R-Mutura/USB_HUB_ADAPTER/IMAGES/USB_HUB_ADAPTER 2.png

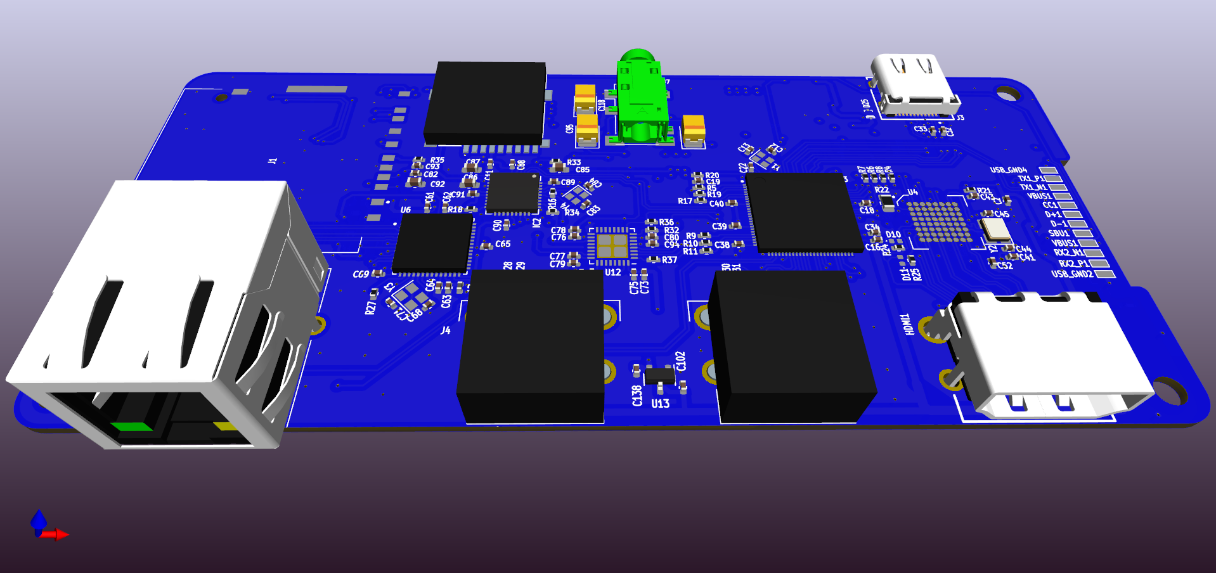
IMAGES/USB_HUB_ADAPTER 2.png
