R-Mutura/USB_HUB_ADAPTER/IMAGES/USB_HUB_ADAPTER 3.png

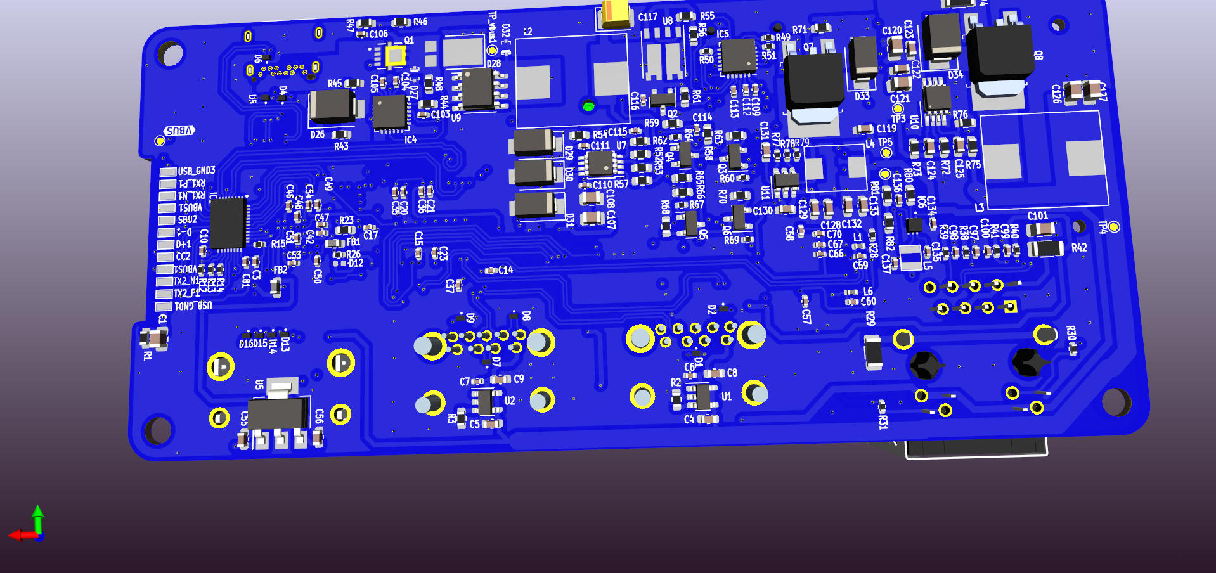
IMAGES/USB_HUB_ADAPTER 3.png
