R-Mutura/USB_HUB_ADAPTER/IMAGES/USB_HUB_ADAPTER.png

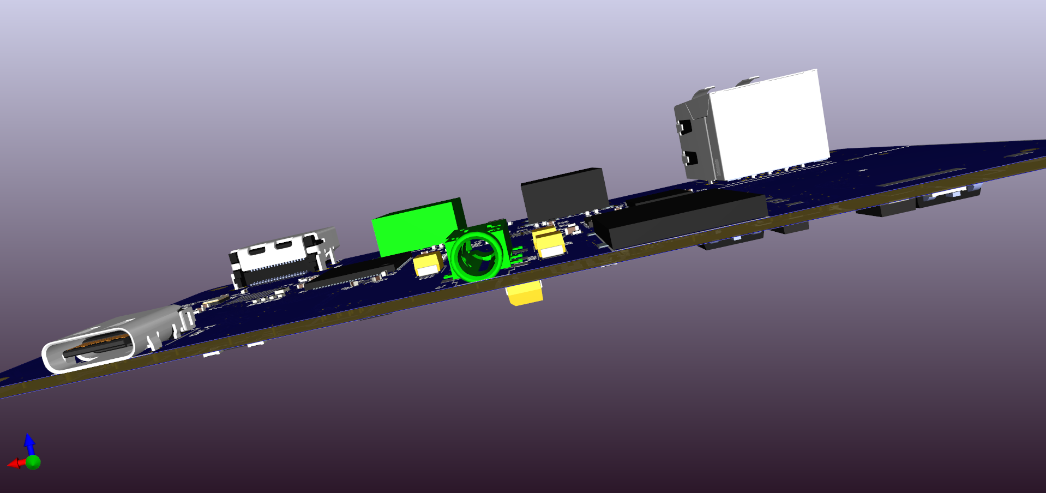
IMAGES/USB_HUB_ADAPTER.png
