R-Mutura/USB_HUB_ADAPTER/BOM/USB_HUB_ADAPTER_V2.xlsx

Reference(s) | Value | Footprint | Description | Mfr No. | Vendor | Qty | Price per unit | Total price
C1 | 100nF | Capacitor_SMD:C_0805_2012Metric |  | 08056D104KAT2A | LCSC | 1 | $0.0084 | $0.0084
C2, C6, C7, C10, C57, C58, C59, C60, C61, C62, C63, C64, C65, C66, C67, C69, C70, C72, C73, C77, C79, C80, C81 | 100nF | Capacitor_SMD:C_0402_1005Metric |  | 0402B104K6R3CT | LCSC | 23 | $0.0012 | $0.0276
C3, C19, C74, C75, C76, C94, C104, C105, C109, C112, C113, C134 | 1uF | Capacitor_SMD:C_0402_1005Metric |  | CL05A105KQ5NNNC | LCSC | 12 | $0.0008 | $0.0096
C4, C5, C8, C9, C55, C56, C128, C129 | 10uF | Capacitor_SMD:C_0603_1608Metric |  | CL10A106MQ8NNNC | LCSC | 8 | $0.0049 | $0.0392
C11, C82, C93 | 1nF | Capacitor_SMD:C_0402_1005Metric |  | C0402C102J1GEC7411 | LCSC | 3 | $0.0182 | $0.0546
C12, C13, C44, C45, C68, C71 | 22pF | Capacitor_SMD:C_0402_1005Metric |  | CC0402JRNPO9BN220 | LCSC | 6 | $0.0010 | $0.0060
C14, C15, C16, C17, C18, C20, C21, C22, C23, C28, C29, C30, C31, C32, C33, C34, C35, C36, C37, C38, C39, C40, C41, C42, C43, C46, C47, C48, C49, C50, C51, C53, C54, C88, C89, C90, C91, C116 | 0.1uF | Capacitor_SMD:C_0402_1005Metric |  | 0402B104K160NT | LCSC | 38 | $0.0008 | $0.0304
C52 | 2.2uF | Capacitor_SMD:C_0402_1005Metric |  | JMK105BJ225MV-F | LCSC | 1 | $0.0024 | $0.0024
C78 | 10uF | Capacitor_SMD:C_0402_1005Metric |  | CL05A106MQ5NUNC | LCSC | 1 | $0.0053 | $0.0053
C83, C84 | 18pF | Capacitor_SMD:C_0402_1005Metric |  | C0402C180K8HAC7867 | LCSC | 2 | $0.0049 | $0.0098
C85, C86 | 1uF_1%_0.1ohm | Capacitor_SMD:C_0603_1608Metric |  | 0603X105K6R3CT | LCSC | 2 | $0.0055 | $0.0110
C87, C92 | 4.7uF | Capacitor_SMD:C_0603_1608Metric |  | CL10A475KQ8NNNC | LCSC | 2 | $0.0037 | $0.0074
C95, C96 | 100uF | Capacitor_Tantalum_SMD:CP_EIA-3528-21_Kemet-B |  | TLJB227M006R0500 | LCSC | 2 | $0.2451 | $0.4902
C97, C98, C99, C100 | 15pF | Capacitor_SMD:C_0402_1005Metric | 50V | 0402CG150J500NT | LCSC | 4 | $0.0010 | $0.0040
C101 | 22pF | Capacitor_SMD:C_0805_2012Metric |  | TCC0805COG220J500BT | LCSC | 1 | $0.0045 | $0.0045
C103 | 1uF_50V | Capacitor_SMD:C_0402_1005Metric |  | CL05A105KA5NQNC | LCSC | 1 | $0.0034 | $0.0034
C106, C110 | 0.1uF_25V | Capacitor_SMD:C_0402_1005Metric |  | GMC04X7R104K25NT | LCSC | 2 | $0.0030 | $0.0060
C111 | 1nF>25v | Capacitor_SMD:C_0402_1005Metric |  | CC0402KRX7R9BB102 | LCSC | 1 | $0.0009 | $0.0009
C114, C115 | 100pF | Capacitor_SMD:C_0402_1005Metric |  | CC0402JRNPO7BN101 | LCSC | 2 | $0.0014 | $0.0028
C117, C118 | 4.7uF | Capacitor_Tantalum_SMD:CP_EIA-3528-21_Kemet-B |  | T494B475K016AT | LCSC | 2 | $0.1872 | $0.3744
C119 | 4.7uF | Capacitor_SMD:C_0603_1608Metric | X5R | CL10A475KQ8NNNC | LCSC | 1 | $0.0037 | $0.0037
C107, C108, C120, C121, C126, C127 | 22uF | Capacitor_SMD:C_0805_2012Metric |  | CL21A226MOQNNNE | JLC | 6 | $0.0236 | $0.1416
C122, C130, C131 | 100nF | Capacitor_SMD:C_0603_1608Metric |  | CL10B104KO8NNNC | LCSC | 3 | $0.0023 | $0.0069
C123 | 470nF | Capacitor_SMD:C_0603_1608Metric |  | CC0603KRX7R7BB474 | LCSC | 1 | $0.0069 | $0.0069
C124 | 1nF | Capacitor_SMD:C_0603_1608Metric |  | CC0603KRX7R6BB102 | LCSC | 1 | $0.0029 | $0.0029
C125 | 1.2nF | Capacitor_SMD:C_0603_1608Metric |  | CC0603JRNPO8BN122 | LCSC | 1 | $0.0087 | $0.0087
C132, C133 | 22uF | Capacitor_SMD:C_0603_1608Metric |  | CL10A226MQ8NRNC | JLC | 2 | $0.0044 | $0.0088
C135 | 4.7uF | Capacitor_SMD:C_0402_1005Metric |  | GRM155R60J475ME87D | LCSC | 1 | $0.0046 | $0.0046
C136 | 120pF_1mOHM | Capacitor_SMD:C_0402_1005Metric |  | 0402B121K500NT |  | 1 | $0.0009 | $0.0009
C137 | 10uF_1mOHM_402 | Capacitor_SMD:C_0402_1005Metric |  | CL05A106MQ5NUNC |  | 1 | $0.0053 | $0.0053
D1, D2, D3, D4, D5, D6, D7, D8, D9, D13, D14, D15, D16 | TVS_SS-ESD122DMXR | greencharge-footprints:DMX0003A | 2-Channel ESD Protection Diode for USB Type-C and HDMI 2.0 | ESD122DMXR | LCSC | 13 | $0.2944 | $3.8272
D10, D11, D12 | D | Diode_SMD:D_0402_1005Metric |  | B5817WS | LCSC | 3 | $0.0168 | $0.0504
D25, D27, D32 | ESDA25P35 | digikey-footprints:SOD-523 | TVS DIODE 3.3V 14.1V SOD523 | ESDA25P35-1U1M | LCSC | 3 | $0.3209 | $0.9627
D26 | SSB44-E3/52T | Diode_SMD:D_SMB |  | ESD5Z3.3T1G-MS | LCSC | 1 | $0.0140 | $0.0140
D28 | SBR10U45SP5-13 | Diode_SMD:D_PowerDI-5 |  | SBR10U45SP5-13 | LCSC | 1 | $0.4089 | $0.4089
D29, D30, D31, D33 | SMAJ30A | Diode_SMD:D_SMA |  | SMAJ30A | LCSC | 4 | $0.0261 | $0.1044
D34 | SK106B | Diode_SMD:D_SMB |  | SK106B | LCSC | 1 | $0.1488 | $0.1488
FB1, FB2 | Ferrite Bead | Inductor_SMD:L_0603_1608Metric |  | YI160808U300-5R0T | LCSC | 2 | $0.0138 | $0.0276
HDMI1 | HDMI_CONN_19pin | greencharge-footprints:HDMI_FEMALE_CONN_685119134923 |  | HDMI-101L | LCSC | 1 | $0.4757 | $0.4757
IC1 | TUSB564 | greencharge-footprints:TUSB564 | USB TYPE-C DP Alt Mode Linear Redriver Crosspoint Switch for Sink Side | HD3SS460RHRR | LCSC | 1 | $2.3562 | $2.3562
IC2 | USB2240-AEZG-06 | Package_DFN_QFN:QFN-36-1EP_6x6mm_P0.5mm_EP3.7x3.7mm | USB2240-AEZG-06, USB Controller 35Mbit/s USB 2.0, 3.3 V, 36-Pin, QFN | USB2240-AEZG-06 | LCSC | 1 | $1.2600 | $1.2600
IC4 | STUSB4500QTR-Interface_USB | Package_DFN_QFN:QFN-24-1EP_4x4mm_P0.5mm_EP2.7x2.7mm |  | STUSB4500QTR | DIGIPART/GANG BO INDUSTRIAL | 1 | $2.2500 | $2.2500
IC5 | STUSB4700YQTR | Package_DFN_QFN:QFN-24-1EP_4x4mm_P0.5mm_EP2.7x2.7mm | USB Interface IC CONDITIONING & INTERFACES | STUSB4700YQTR | LCSC | 1 | $2.3960 | $2.3960
IC6 | TPS62824ADMQR | greencharge-footprints:TPS62824ADMQR | Switching Voltage Regulators 2.4-V to 5.5-V input, 1-A step-down converter with forced PWM in 1.5-mm 1.5-mm QFN package 6-VSON-HR -40 to 125 | TPS62821DLCT | LCSC | 1 | $3.6735 | $3.6735
J1 | SD-106M | greencharge-footprints:sd_card_SD106M | Connector - Card Sockets 29.2x28.5x2.8mm | SD-106M | LCSC | 1 | $0.4010 | $0.4010
J2 | TF-115-BCP9 | greencharge-footprints:sd_tf_card_TF115BCP9 | -25~{+85} 1.8mm Tin Deck MicroSD card (TF card) 260 C5191 Self bomb SMD SD Card Connectors ROHS | TF-115-BCP9 | LCSC | 1 | $0.0805 | $0.0805
J3 | TYPEC-324DBW-ACP24A | greencharge-footprints:GCT_USB4056-03-A_REVA |  | TYPEC-324DBW-ACP24A | LCSC | 1 | $0.4948 | $0.4948
J4, J5 | USB3_A | greencharge-footprints:usb_A_3.0_U231091N3GRC105 |  | U231-091N-3GRC10-5 | LCSC | 2 | $0.3325 | $0.6650
J6 | RJ_45_CONN_100G_J1B1211CCD | greencharge-footprints:RJ45_CONN_J1B1211CCD |  | J1B1211CCD | LCSC | 1 | $2.4055 | $2.4055
J7 | 54-00178 | Connector_Audio:Jack_3.5mm_PJ311_Horizontal |  | PJ-3111-3A | LCSC | 1 | $0.1735 | $0.1735
L1, L6 | 0.5A_120R_100MHz | Inductor_SMD:L_0402_1005Metric |  | HK10053N6S-T | LCSC | 2 | $0.0051 | $0.0102
L2 | MWSA1004S-100MT | greencharge-footprints:MWSA1004S-3R3MT | 7.8A 10uH Â±20% 30mÎ© SMD Power Inductors ROHS | MWSA1004S-100MT | LCSC | 1 | $0.1991 | $0.1991
L3 | 8.2uH_8A | greencharge-footprints:MWSA1004S-3R3MT |  | MWSA1004S-8R2MT | LCSC | 1 | $0.2162 | $0.2162
L4 | YSPI0520-4R7M | greencharge-footprints:YSPI0520 |  | YSPI0520-4R7M | LCSC | 1 | $0.1721 | $0.1721
L5 | 470nH_30m | greencharge-footprints:DFE252012PD-xxx |  | DFE252012PD-R47M=P2 | LCSC | 1 | $0.1826 | $0.1826
L7 | 2A_BEAD | Inductor_SMD:L_0402_1005Metric |  | HCB1005KF-100T20 | LCSC | 1 | $0.0032 | $0.0032
Q1 | STL6P3LLH6 | greencharge-footprints:STL6P3LLH6 |  | STL6P3LLH6 | DIGIPART/WINSOURCE | 1 | $0.4870 | $0.4870
Q2 | SI2307A | Package_TO_SOT_SMD:SOT-23 |  | SI2307A | LCSC | 1 | $0.0447 | $0.0447
Q3, Q4, Q5, Q6 | BSH105,215 | Package_TO_SOT_SMD:SOT-23 | MOSFET N-CH 60V 0.36A SOT-23 | 2N7002-HXY | LCSC | 4 | $0.0152 | $0.0608
Q7 | HSU4103 | greencharge-footprints:TO-252-3_tabpin-2 |  | HSU4103 | LCSC | 1 | $0.2349 | $0.2349
Q8 | AP25P06K | greencharge-footprints:TO-252-3_tabpin-2 |  | AP25P06K | LCSC | 1 | $0.1265 | $0.1265
R1 | 0R | Resistor_SMD:R_0603_1608Metric |  | FRC0603P000 TS | LCSC | 1 | $0.0007 | $0.0007
R2, R3 | 6.8K | Resistor_SMD:R_0603_1608Metric |  | FRC0603J682 TS | LCSC | 2 | $0.0008 | $0.0016
R4, R12, R13, R14, R15 | 1K | Resistor_SMD:R_0402_1005Metric |  | FRC0402J102 TS | LCSC | 5 | $0.0004 | $0.0020
R5, R6, R7, R8, R9, R19, R32, R34, R35, R36, R79 | 10K | Resistor_SMD:R_0402_1005Metric |  | 0402WGJ0103TCE | LCSC | 11 | $0.0004 | $0.0044
R10, R11 | 200K | Resistor_SMD:R_0402_1005Metric |  | 0402WGJ0204TCE | LCSC | 2 | $0.0004 | $0.0008
R16 | 1M | Resistor_SMD:R_0402_1005Metric |  | FRC0402J105 TS | LCSC | 1 | $0.0004 | $0.0004
R17 | 47K | Resistor_SMD:R_0402_1005Metric |  | 0402WGJ0473TCE | LCSC | 1 | $0.0004 | $0.0004
R18, R49, R50, R51, R60, R64, R67, R69 | 100K | Resistor_SMD:R_0402_1005Metric |  | 0402WGJ0104TCE | LCSC | 8 | $0.0004 | $0.0032
R20, R27, R28 | 12K | Resistor_SMD:R_0402_1005Metric |  | CR0402JF0123G | LCSC | 3 | $0.0004 | $0.0012
R21 | 2.2K_402 | Resistor_SMD:R_0402_1005Metric |  | 0402WGJ0222TCE | LCSC | 1 | $0.0004 | $0.0004
R22 | 100K | Resistor_SMD:R_0805_2012Metric |  | FRC0805J104 TS | LCSC | 1 | $0.0012 | $0.0012
R23 | 249OHM/1% | Resistor_SMD:R_0603_1608Metric |  | 0603WAF2490T5E | LCSC | 1 | $0.0010 | $0.0010
R24, R25, R26 | 4.7K | Resistor_SMD:R_0402_1005Metric |  | 0402WGJ0472TCE | LCSC | 3 | $0.0004 | $0.0012
R29, R42 | 0R_1206 | Resistor_SMD:R_1206_3216Metric |  | FRC1206P000 TS | LCSC | 2 | $0.0020 | $0.0040
R30, R31 | 332R | Resistor_SMD:R_0402_1005Metric |  | 0402WGF3320TCE | LCSC | 2 | $0.0005 | $0.0010
R33 | 12K_1% | Resistor_SMD:R_0402_1005Metric |  | 0402WGF1202TCE | LCSC | 1 | $0.0005 | $0.0005
R37, R38, R39, R40, R41 | 49.9R | Resistor_SMD:R_0402_1005Metric |  | 0402WGF499JTCE | LCSC | 5 | $0.0005 | $0.0025
R43 | 470 | Resistor_SMD:R_0603_1608Metric |  | FRC0603J471 TS | LCSC | 1 | $0.0007 | $0.0007
R44, R48 | 1K | Resistor_SMD:R_0603_1608Metric |  | 0603WAF1001T5E | LCSC | 2 | $0.0005 | $0.0010
R45, R52, R80, R82 | 100K | Resistor_SMD:R_0603_1608Metric |  | FRC0603F2003TS | LCSC | 4 | $0.0009 | $0.0036
R46, R47 | 22K | Resistor_SMD:R_0603_1608Metric |  | FRC0603J223 TS | LCSC | 2 | $0.0008 | $0.0016
R53 | 11K | Resistor_SMD:R_0603_1608Metric |  | 0603WAJ0113T5E | LCSC | 1 | $0.0009 | $0.0009
R54 | 47.5K | Resistor_SMD:R_0603_1608Metric |  | FRC0603F4752TS | LCSC | 1 | $0.0009 | $0.0009
R55, R61, R71, R75 | 10K | Resistor_SMD:R_0603_1608Metric |  | FRC0603J103TS | LCSC | 4 | $0.0007 | $0.0028
R56 | 2.2K | Resistor_SMD:R_0603_1608Metric |  | FRC0603J222 TS | LCSC | 1 | $0.0008 | $0.0008
R57 | 270 | Resistor_SMD:R_0603_1608Metric |  | FRC0603J271 TS | LCSC | 1 | $0.0008 | $0.0008
R58 | 9.53K | Resistor_SMD:R_0603_1608Metric |  | 0603WAF9531T5E | LCSC | 1 | $0.0011 | $0.0011
R59 | 820 | Resistor_SMD:R_0603_1608Metric |  | 0603WAJ0821T5E | LCSC | 1 | $0.0008 | $0.0008
R62 | 30K | Resistor_SMD:R_0603_1608Metric |  | FRC0603J303 TS | LCSC | 1 | $0.0008 | $0.0008
R63 | 8.87K_603 | Resistor_SMD:R_0603_1608Metric |  | 0603WAF8871T5E | LCSC | 1 | $0.0009 | $0.0009
R65 | 3K_603 | Resistor_SMD:R_0603_1608Metric |  | FRC0603J302 TS | LCSC | 1 | $0.0008 | $0.0008
R66 | 2.4K_603 | Resistor_SMD:R_0603_1608Metric |  | 0603WAJ0242T5E | LCSC | 1 | $0.0008 | $0.0008
R68 | 3.65K_603 | Resistor_SMD:R_0603_1608Metric |  | 0603WAF3651T5E | LCSC | 1 | $0.0009 | $0.0009
R70 | 2.2K_805 | Resistor_SMD:R_0603_1608Metric |  | FRC0603J222 TS | LCSC | 1 | $0.0008 | $0.0008
R72 | 44.2K | Resistor_SMD:R_0603_1608Metric |  | FRC0603F4422TS | LCSC | 1 | $0.0009 | $0.0009
R73 | 2.21K | Resistor_SMD:R_0603_1608Metric |  | FRC0603F2211TS | LCSC | 1 | $0.0009 | $0.0009
R74 | 10m | Resistor_SMD:R_1206_3216Metric |  | MFJ06HR010FT | LCSC | 1 | $0.0405 | $0.0405
R76 | 3.32K | Resistor_SMD:R_0603_1608Metric |  | 0603WAF3321T5E | LCSC | 1 | $0.0009 | $0.0009
R77 | 30R | Resistor_SMD:R_0402_1005Metric |  | 0402WGJ0300TCE | LCSC | 1 | $0.0004 | $0.0004
R78 | 30.9K | Resistor_SMD:R_0402_1005Metric |  | FRC0402F3092TS | LCSC | 1 | $0.0005 | $0.0005
R81 | 82.5K | Resistor_SMD:R_0603_1608Metric |  | 0603WAF8252T5E | LCSC | 1 | $0.0009 | $0.0009
U1, U2 | SY6280 | Package_TO_SOT_SMD:SOT-23-5 |  | SY6280AAC | JLC | 2 | $0.1847 | $0.3694
U3 | USB7206-usb_hub_controller | greencharge-footprints:QFN-100_40P1200X1200X90-101N-D |  | USB7206CT/KDX | MOUSER | 1 | $11.0300 | $11.0300
U4 | MCDP2900 | greencharge-footprints:BGA-64_8x8_7.0x7.0mm_MCDP2900 |  | MCDP2900A4T | DIGIKEY | 1 | $11.1500 | $11.1500
U5 | ZLDO1117G12TA | Package_TO_SOT_SMD:SOT-223-3_TabPin2 |  | ZLDO1117G12TA | JLC | 1 | $0.3362 | $0.3362
U6 | LAN9500AI-ABZJ-TR | greencharge-footprints:LAN950X_QFN50P800X800X100-57N |  | LAN9500AI-ABZJ-TR | JLC | 1 | $3.6795 | $3.6795
U7 | LM3489QMM | Package_SO:TSSOP-8_3x3mm_P0.65mm |  | LM3489MM/NOPB | JLC | 1 | $1.9600 | $1.9600
U8 | SQJ951EP | Package_SO:PowerPAK_SO-8_Dual |  | SQJ951EP-T1_GE3 | MOUSER | 1 | $1.7500 | $1.7500
U9 | CWDM3011P | Package_SO:SOIC-8_3.9x4.9mm_P1.27mm |  | CWDM3011P TR13 PBFREE | DIGIKEY | 1 | $0.9700 | $0.9700
U10 | LM25085MM/NOPB | Package_SO:VSSOP-8_3.0x3.0mm_P0.65mm |  | LM25085MM/NOPB | JLC | 1 | $1.6710 | $1.6710
U11 | TPS56339DDCR | Package_TO_SOT_SMD:SOT-23-6 |  | TPS56339DDCR | JLC | 1 | $2.5365 | $2.5365
U12 | TLV320AIC3104IRHBR | Package_DFN_QFN:VQFN-32-1EP_5x5mm_P0.5mm_EP3.5x3.5mm |  | TLV320AIC3104IRHBR | JLC | 1 | $1.7550 | $1.7550
Y1 | 25MHz_402F2501XIAR | Crystal:Crystal_SMD_2016-4Pin_2.0x1.6mm |  | ABM11-25.000MHZ-D2X-T3 | DIGIKEY | 1 | $0.7300 | $0.7300
Y2 | 27MHz | Crystal:Crystal_SMD_Abracon_ABM8G-4Pin_3.2x2.5mm |  | ABM8G-27.000MHZ-B4Y-T | DIGIKEY | 1 | $0.6400 | $0.6400
Y3 | 25MHz | Crystal:Crystal_SMD_2520-4Pin_2.5x2.0mm |  | 7E25000E12UCG | LCSC | 1 | $0.1306 | $0.1306
Y4 | 24.0MHz | Crystal:Crystal_SMD_2016-4Pin_2.0x1.6mm |  | ABM11-24.000MHZ-D2X-T3 | DIGIKEY | 1 | $0.7400 | $0.7400
 |  |  |  |  |  |  | TOTAL | $64.7409
