R-Mutura/USB_HUB_ADAPTER/USB_HUB_ADAPTER/AUDIO_DAC_CONVERTER.kicad_sch

## KiCad design USB_HUB_ADAPTER/AUDIO_DAC_CONVERTER.kicad_sch (2022-11-23)

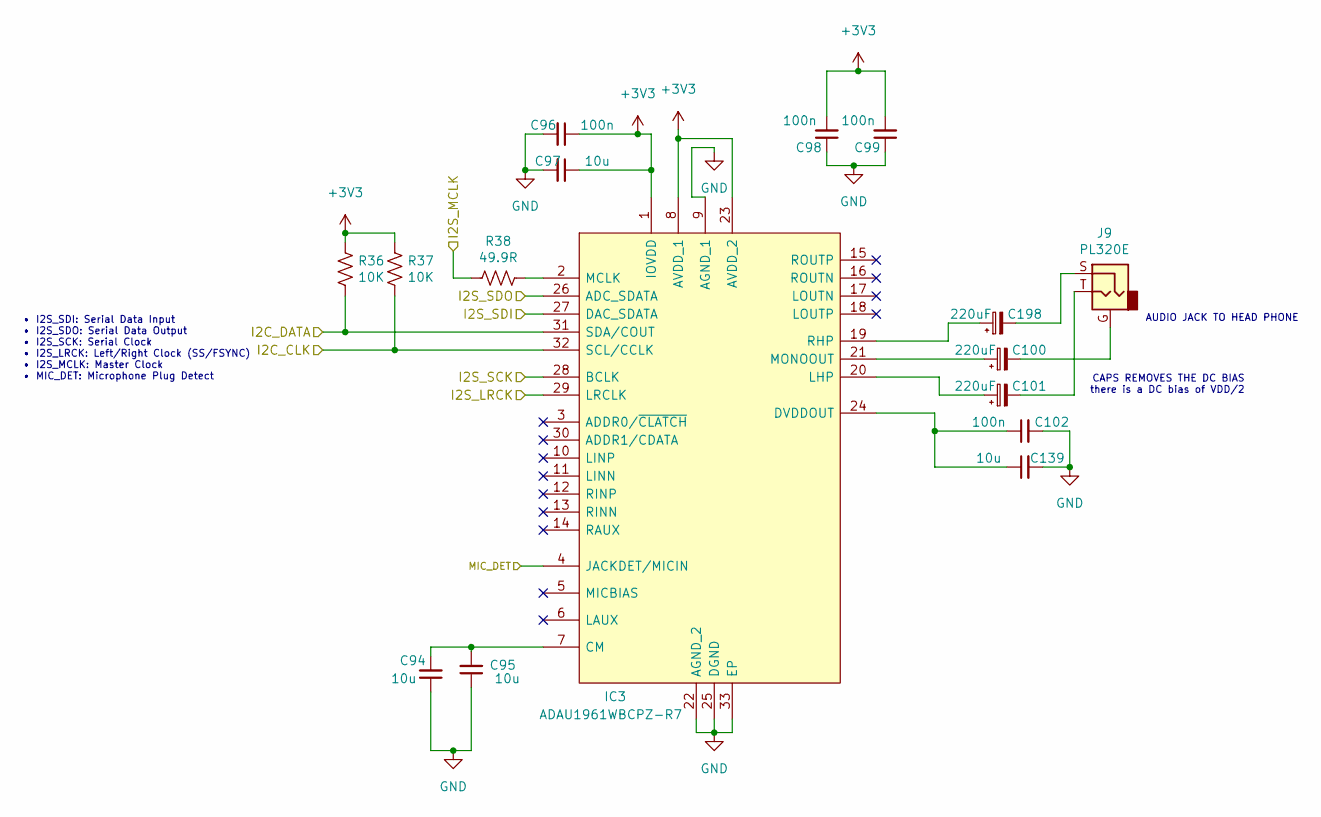
[picture p17: schematic AUDIO_DAC_CONVERTER.kicad_sch]

Parts:
C94, C95: 10u; C_0603_1608Metric
C96, C98, C99, C102: 100n; C_0402_1005Metric
C97, C139: 10u; C_0402_1005Metric
C100, C101, C198: 220uF; CP_EIA-3528-21_Kemet-B
IC3: ADAU1961WBCPZ-R7; LFCSP-32-1EP_5x5mm_P0.5mm_EP3.6x3.6mm; Mouser Part Number 584-ADAU1961WBCPZ-R7
J9: PL320E; Jack_3.5mm_PJ320E_Horizontal
R36, R37: 10K; R_0402_1005Metric
R38: 49.9R; R_0402_1005Metric

Connections:
+3V3: C96.1, C97.1, C98.2, C99.2, IC3.1 (IOVDD), IC3.8 (AVDD_1), IC3.23 (AVDD_2), R36.1, R37.1
GND: C94.1, C95.1, C96.2, C97.2, C98.1, C99.1, C102.2, C139.2, IC3.9 (AGND_1), IC3.22 (AGND_2), IC3.25 (DGND), IC3.33 (EP)
I2C_CLK: IC3.32 (SCL/CCLK), R37.2
I2C_DATA: IC3.31 (SDA/COUT), R36.2
I2S_LRCK: IC3.29 (LRCLK)
I2S_MCLK: R38.1
I2S_SCK: IC3.28 (BCLK)
I2S_SDI: IC3.27 (DAC_SDATA)
I2S_SDO: IC3.26 (ADC_SDATA)
MIC_DET: IC3.4 (JACKDET/MICIN)
unnamed: C94.2, C95.2, IC3.7 (CM)
unnamed: C100.1, IC3.21 (MONOOUT)
unnamed: C100.2, J9.G
unnamed: C101.1, IC3.20 (LHP)
unnamed: C101.2, J9.T
unnamed: C102.1, C139.1, IC3.24 (DVDDOUT)
unnamed: C198.1, IC3.19 (RHP)
unnamed: C198.2, J9.S
unnamed: IC3.2 (MCLK), R38.2

Notes on the sheet:
AUDIO JACK TO HEAD PHONE
• I2S_SDI: Serial Data Input • I2S_SDO: Serial Data Output • I2S_SCK: Serial Clock • I2S_LRCK: Left/Right Clock (SS/FSYNC) • I2S_MCLK: Master Clock • MIC_DET: Microphone Plug Detect
CAPS REMOVES THE DC BIAS there is a DC bias of VDD/2
