R-Mutura/USB_HUB_ADAPTER/USB_HUB_ADAPTER/BUCK_CONVERTER_3V3_2A.kicad_sch

## KiCad design USB_HUB_ADAPTER/BUCK_CONVERTER_3V3_2A.kicad_sch (2022-11-23)

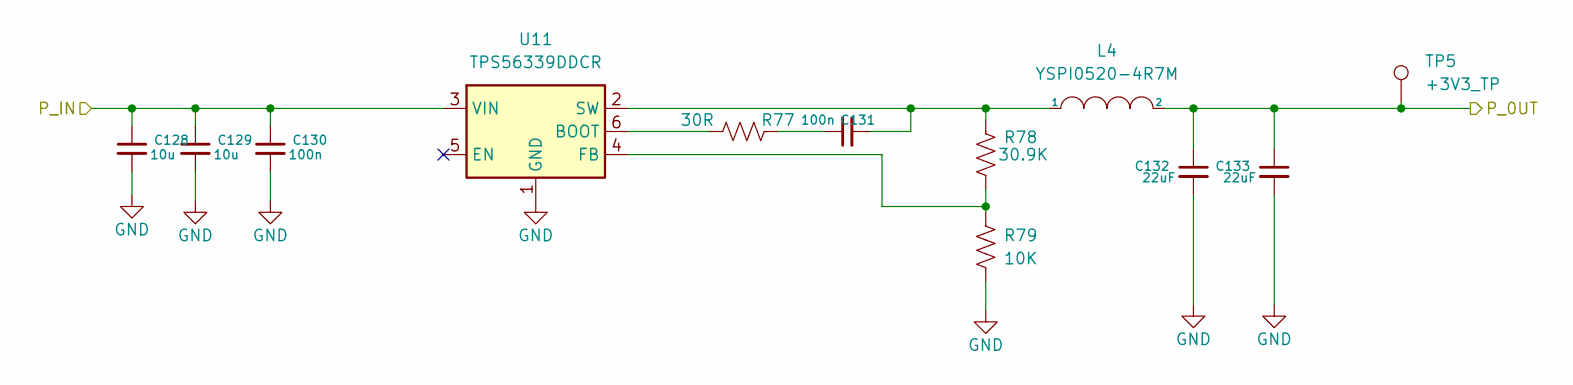
[picture p18: schematic BUCK_CONVERTER_3V3_2A.kicad_sch]

Parts:
C128, C129: 10u; C_0603_1608Metric
C130, C131: 100n; C_0603_1608Metric
C132, C133: 22uF; C_0603_1608Metric
L4: YSPI0520-4R7M; YSPI0520
R77: 30R; R_0402_1005Metric
R78: 30.9K; R_0402_1005Metric
R79: 10K; R_0402_1005Metric
TP5: +3V3_TP; TestPoint_Pad_D0.9mm
U11: TPS56339DDCR; SOT-23-6

Connections:
GND: C128.2, C129.2, C130.2, C132.2, C133.2, R79.2, U11.1 (GND)
unnamed: C131.1, R77.2
unnamed: C131.2, L4.1, R78.1, U11.2 (SW)
unnamed: R77.1, U11.6 (BOOT)
unnamed: R78.2, R79.1, U11.4 (FB)
P_0UT: C132.1, C133.1, L4.2, TP5.1
P_IN: C128.1, C129.1, C130.1, U11.3 (VIN)
