R-Mutura/USB_HUB_ADAPTER/USB_HUB_ADAPTER/BUCK_CONVERTER_5V_5A_LM25085.kicad_sch

## KiCad design USB_HUB_ADAPTER/BUCK_CONVERTER_5V_5A_LM25085.kicad_sch (2022-11-23)

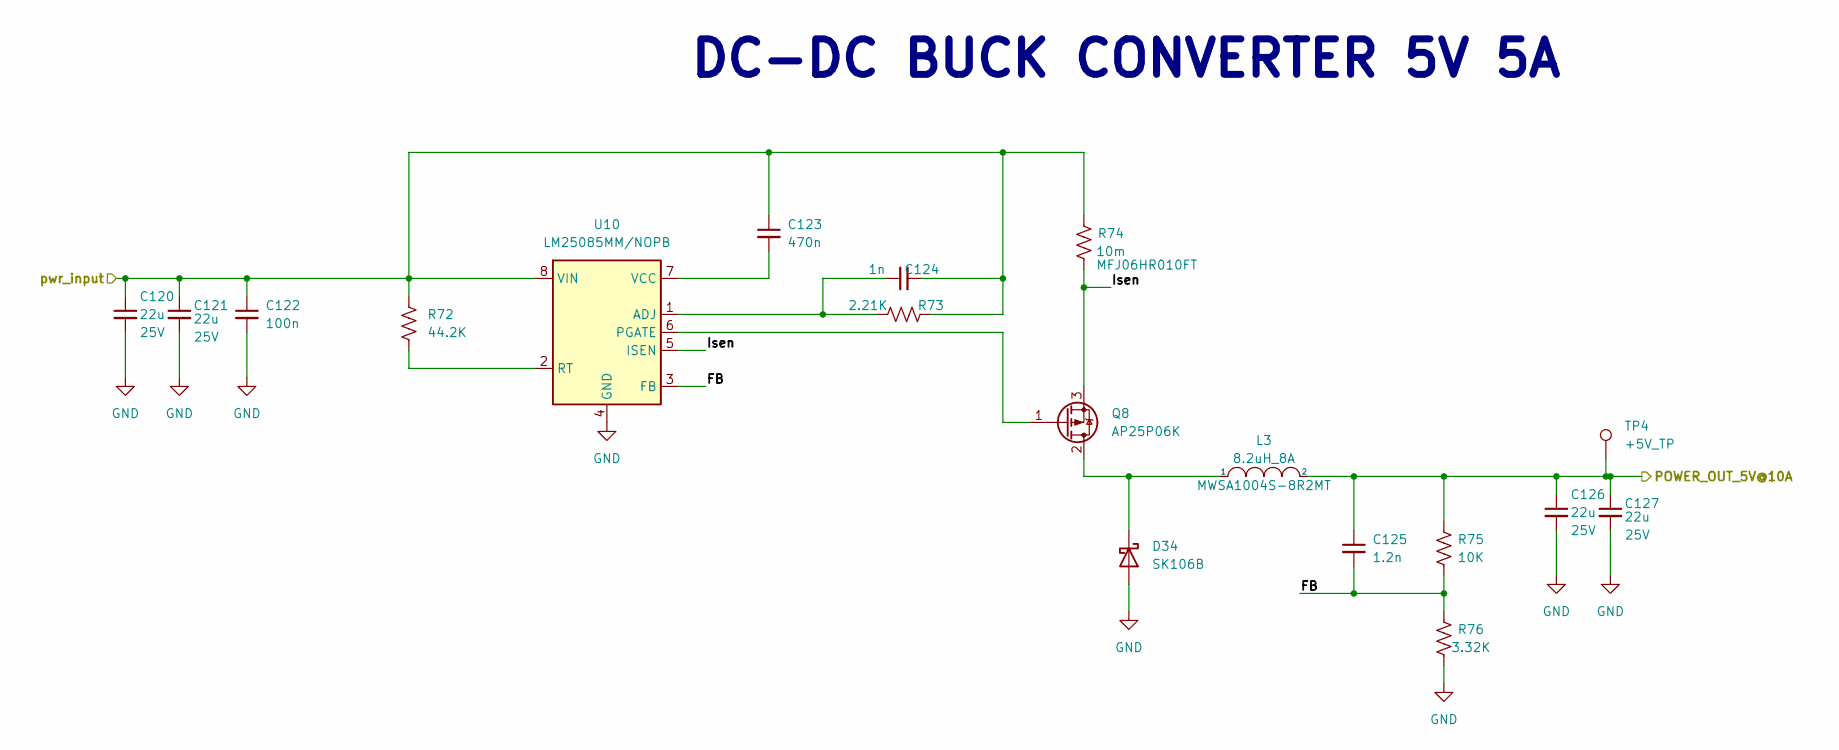
[picture p19: schematic BUCK_CONVERTER_5V_5A_LM25085.kicad_sch]

Parts:
C120, C121, C126, C127: 22u; C_0805_2012Metric
C122: 100n; C_0603_1608Metric
C123: 470n; C_0603_1608Metric
C124: 1n; C_0603_1608Metric
C125: 1.2n; C_0603_1608Metric
D34: SK106B; D_SMB
L3: 8.2uH_8A; MWSA1004S-3R3MT; MPN MWSA1004S-8R2MT
Q8: AP25P06K; TO-252-3_tabpin-2
R72: 44.2K; R_0603_1608Metric
R73: 2.21K; R_0603_1608Metric
R74: 10m; R_1206_3216Metric; MPN MFJ06HR010FT
R75: 10K; R_0603_1608Metric
R76: 3.32K; R_0603_1608Metric
TP4: +5V_TP; TestPoint_Pad_D0.9mm
U10: LM25085MM/NOPB; VSSOP-8_3.0x3.0mm_P0.65mm

Connections:
FB: C125.2, R75.1, R76.2, U10.3 (FB)
GND: C120.2, C121.2, C122.2, C126.2, C127.2, D34.2 (A), R76.1, U10.4 (GND)
Isen: Q8.3 (S), R74.1, U10.5 (ISEN)
unnamed: C123.2, U10.7 (VCC)
unnamed: C124.1, R73.1, U10.1 (ADJ)
unnamed: D34.1 (K), L3.1, Q8.2 (D)
unnamed: Q8.1 (G), U10.6 (PGATE)
unnamed: R72.2, U10.2 (RT)
POWER_OUT_5V@10A: C125.1, C126.1, C127.1, L3.2, R75.2, TP4.1
pwr_input: C120.1, C121.1, C122.1, C123.1, C124.2, R72.1, R73.2, R74.2, U10.8 (VIN)

Notes on the sheet:
DC-DC BUCK CONVERTER 5V 5A
