R-Mutura/USB_HUB_ADAPTER/USB_HUB_ADAPTER/DP TO HDMI INTERFACE.kicad_sch

## KiCad design USB_HUB_ADAPTER/DP TO HDMI INTERFACE.kicad_sch (2022-11-23)

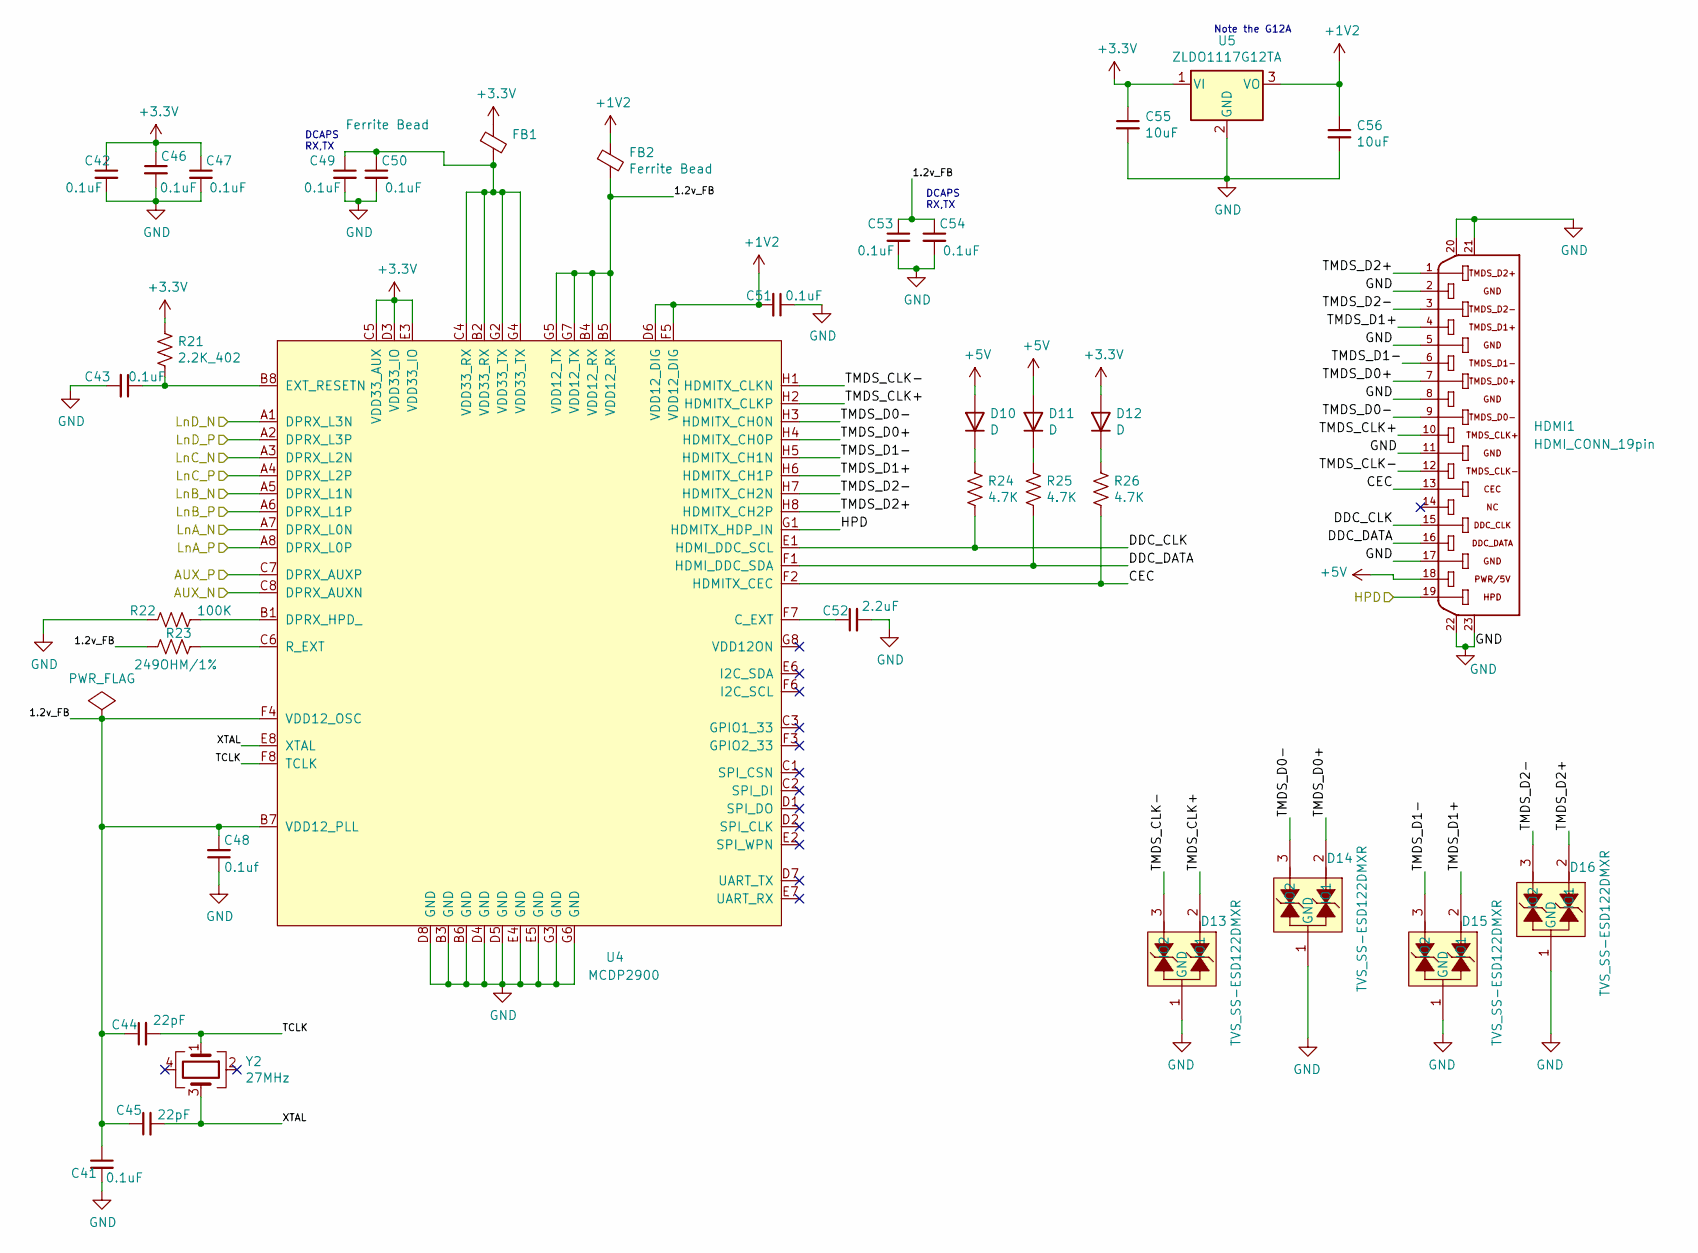
[picture p20: schematic DP TO HDMI INTERFACE.kicad_sch]

Parts:
C41, C42, C43, C46, C47, C49, C50, C51, C53, C54: 0.1uF; C_0402_1005Metric
C44, C45: 22pF; C_0402_1005Metric
C48: 0.1uf; C_0402_1005Metric
C52: 2.2uF; C_0402_1005Metric
C55, C56: 10uF; C_0603_1608Metric
D10, D11, D12: D; D_0402_1005Metric
D13, D14, D15, D16: TVS_SS-ESD122DMXR; DMX0003A; Mouser Part Number 595-ESD122DMXR
FB1, FB2: Ferrite Bead; L_0603_1608Metric
HDMI1: HDMI_CONN_19pin; HDMI_FEMALE_CONN_685119134923
R21: 2.2K_402; R_0402_1005Metric
R22: 100K; R_0805_2012Metric
R23: 249OHM/1%; R_0603_1608Metric
R24, R25, R26: 4.7K; R_0402_1005Metric
U4: MCDP2900; BGA-64_8x8_7.0x7.0mm_MCDP2900
U5: ZLDO1117G12TA; SOT-223-3_TabPin2
Y2: 27MHz; Crystal_SMD_Abracon_ABM8G-4Pin_3.2x2.5mm

Connections:
1.2v_FB: C41.1, C44.1, C45.1, C48.2, C53.1, C54.1, FB2.2, R23.2, U4.B4 (VDD12_RX), U4.B5 (VDD12_RX), U4.B7 (VDD12_PLL), U4.F4 (VDD12_OSC), U4.G5 (VDD12_TX), U4.G7 (VDD12_TX)
+1V2: C51.2, C56.1, FB2.1, U4.D6 (VDD12_DIG), U4.F5 (VDD12_DIG), U5.3 (VO)
+3.3V: C42.1, C46.1, C47.1, C55.1, D12.2 (A), FB1.1, R21.1, U4.C5 (VDD33_AUX), U4.D3 (VDD33_IO), U4.E3 (VDD33_IO), U5.1 (VI)
+5V: D10.2 (A), D11.2 (A), HDMI1.18
AUX_N: U4.C8 (DPRX_AUXN)
AUX_P: U4.C7 (DPRX_AUXP)
CEC: HDMI1.13, R26.2, U4.F2 (HDMITX_CEC)
DDC_CLK: HDMI1.15, R24.2, U4.E1 (HDMI_DDC_SCL)
DDC_DATA: HDMI1.16, R25.2, U4.F1 (HDMI_DDC_SDA)
GND: C41.2, C42.2, C43.2, C46.2, C47.2, C48.1, C49.2, C50.2, C51.1, C52.2, C53.2, C54.2, C55.2, C56.2, D13.1 (GND), D14.1 (GND), D15.1 (GND), D16.1 (GND), HDMI1.2, HDMI1.5, HDMI1.8, HDMI1.11, HDMI1.17, HDMI1.20, HDMI1.21, HDMI1.22, HDMI1.23, R22.2, U4.B3 (GND), U4.B6 (GND), U4.D4 (GND), U4.D5 (GND), U4.D8 (GND), U4.E4 (GND), U4.E5 (GND), U4.G3 (GND), U4.G6 (GND), U5.2 (GND)
HPD: HDMI1.19, U4.G1 (HDMITX_HDP_IN)
LnA_N: U4.A7 (DPRX_L0N)
LnA_P: U4.A8 (DPRX_L0P)
LnB_N: U4.A5 (DPRX_L1N)
LnB_P: U4.A6 (DPRX_L1P)
LnC_N: U4.A3 (DPRX_L2N)
LnC_P: U4.A4 (DPRX_L2P)
LnD_N: U4.A1 (DPRX_L3N)
LnD_P: U4.A2 (DPRX_L3P)
unnamed: C43.1, R21.2, U4.B8 (EXT_RESETN)
unnamed: C49.1, C50.1, FB1.2, U4.B2 (VDD33_RX), U4.C4 (VDD33_RX), U4.G2 (VDD33_TX), U4.G4 (VDD33_TX)
unnamed: C52.1, U4.F7 (C_EXT)
unnamed: D10.1 (K), R24.1
unnamed: D11.1 (K), R25.1
unnamed: D12.1 (K), R26.1
unnamed: R22.1, U4.B1 (DPRX_HPD_)
unnamed: R23.1, U4.C6 (R_EXT)
TCLK: C44.2, U4.F8 (TCLK), Y2.1
TMDS_CLK+: D13.2 (IO1), HDMI1.10, U4.H2 (HDMITX_CLKP)
TMDS_CLK-: D13.3 (IO2), HDMI1.12, U4.H1 (HDMITX_CLKN)
TMDS_D0+: D14.2 (IO1), HDMI1.7, U4.H4 (HDMITX_CH0P)
TMDS_D0-: D14.3 (IO2), HDMI1.9, U4.H3 (HDMITX_CH0N)
TMDS_D1+: D15.2 (IO1), HDMI1.4, U4.H6 (HDMITX_CH1P)
TMDS_D1-: D15.3 (IO2), HDMI1.6, U4.H5 (HDMITX_CH1N)
TMDS_D2+: D16.2 (IO1), HDMI1.1, U4.H8 (HDMITX_CH2P)
TMDS_D2-: D16.3 (IO2), HDMI1.3, U4.H7 (HDMITX_CH2N)
XTAL: C45.2, U4.E8 (XTAL), Y2.3

Notes on the sheet:
DCAPS RX,TX
Note the G12A
