R-Mutura/USB_HUB_ADAPTER/USB_HUB_ADAPTER/ETHERNET_TO_USB_PHY_LAN7805.kicad_sch

## KiCad design USB_HUB_ADAPTER/ETHERNET_TO_USB_PHY_LAN7805.kicad_sch (2022-11-23)

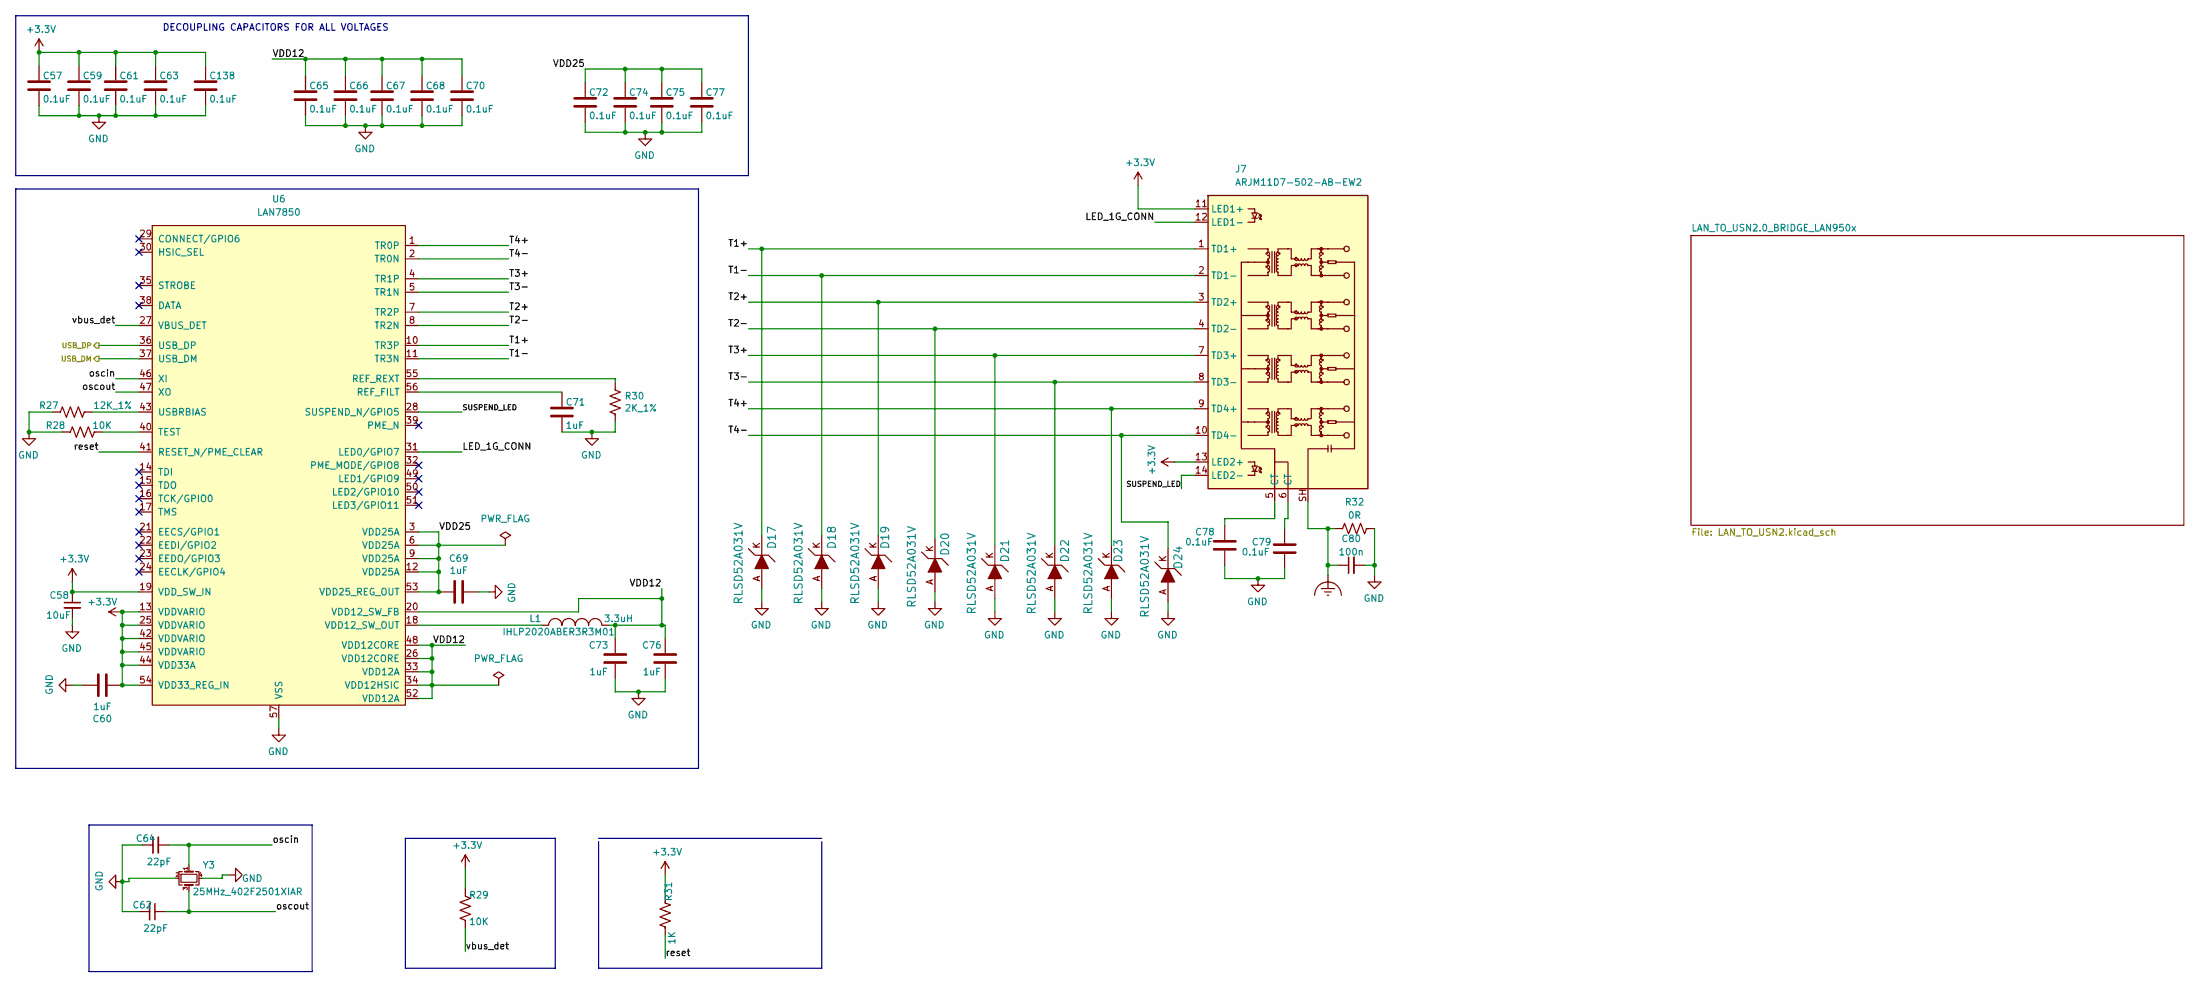
[picture p21: schematic ETHERNET_TO_USB_PHY_LAN7805.kicad_sch]

Parts:
C57, C59, C61, C63, C65, C66, C67, C68, C70, C72, C74, C75, C77, C78, C79, C138: 0.1uF; C_0402_1005Metric
C58: 10uF; C_0603_1608Metric
C60, C69, C71, C73, C76: 1uF; C_0402_1005Metric
C62, C64: 22pF; C_0402_1005Metric
C80: 100n; C_0805_2012Metric
D17, D18, D19, D20, D21, D22, D23, D24: RLSD52A031V; SOD-523; MPN ESD5Z3.3T1G; Digi-Key_PN ESD5Z3.3T1GOSCT-ND
J7: ARJM11D7-502-AB-EW2; ARJM11D7502ABEW2
L1: 3.3uH; IHLP2020
R27: 12K_1%; R_0402_1005Metric
R28, R29: 10K; R_0402_1005Metric
R30: 2K_1%; R_0402_1005Metric
R31: 1K; R_0402_1005Metric
R32: 0R; R_0603_1608Metric
U6: LAN7850; QFN-56-1EP_8x8mm_P0.5mm_EP5.6x5.6mm
Y3: 25MHz_402F2501XIAR; Crystal_SMD_2016-4Pin_2.0x1.6mm

Connections:
+3.3V: C57.1, C58.1, C59.1, C60.2, C61.1, C63.1, C138.1, J7.11 (LED1+), J7.13 (LED2+), R29.1, R31.1, U6.13 (VDDVARIO), U6.19 (VDD_SW_IN), U6.25 (VDDVARIO), U6.42 (VDDVARIO), U6.44 (VDD33A), U6.45 (VDDVARIO), U6.54 (VDD33_REG_IN)
Earth_Clean: C80.1, J7.SH, R32.1
GND: C57.2, C58.2, C59.2, C60.1, C61.2, C62.2, C63.2, C64.2, C65.2, C66.2, C67.2, C68.2, C69.1, C70.2, C71.2, C72.2, C73.2, C74.2, C75.2, C76.2, C77.2, C78.2, C79.2, C80.2, C138.2, D17.A, D18.A, D19.A, D20.A, D21.A, D22.A, D23.A, D24.A, R27.1, R28.1, R30.2, R32.2, U6.57 (VSS), Y3.2, Y3.4
LED_1G_CONN: J7.12 (LED1-), U6.31 (LED0/GPIO7)
unnamed: C71.1, U6.56 (REF_FILT)
unnamed: C78.1, J7.5 (CT)
unnamed: C79.1, J7.6 (CT)
unnamed: L1.1, U6.18 (VDD12_SW_OUT)
unnamed: R27.2, U6.43 (USBRBIAS)
unnamed: R28.2, U6.40 (TEST)
unnamed: R30.1, U6.55 (REF_REXT)
SUSPEND_LED: J7.14 (LED2-), U6.28 (SUSPEND_N/GPIO5)
T1+: D17.K, J7.1 (TD1+), U6.10 (TR3P)
T1-: D18.K, J7.2 (TD1-), U6.11 (TR3N)
T2+: D19.K, J7.3 (TD2+), U6.7 (TR2P)
T2-: D20.K, J7.4 (TD2-), U6.8 (TR2N)
T3+: D21.K, J7.7 (TD3+), U6.4 (TR1P)
T3-: D22.K, J7.8 (TD3-), U6.5 (TR1N)
T4+: D23.K, J7.9 (TD4+), U6.1 (TR0P)
T4-: D24.K, J7.10 (TD4-), U6.2 (TR0N)
USB_DM: U6.37 (USB_DM)
USB_DP: U6.36 (USB_DP)
VDD12: C65.1, C66.1, C67.1, C68.1, C70.1, C73.1, C76.1, L1.2, U6.20 (VDD12_SW_FB), U6.26 (VDD12CORE), U6.33 (VDD12A), U6.34 (VDD12HSIC), U6.48 (VDD12CORE), U6.52 (VDD12A)
VDD25: C69.2, C72.1, C74.1, C75.1, C77.1, U6.3 (VDD25A), U6.6 (VDD25A), U6.9 (VDD25A), U6.12 (VDD25A), U6.53 (VDD25_REG_OUT)
oscin: C64.1, U6.46 (XI), Y3.1
oscout: C62.1, U6.47 (XO), Y3.3
reset: R31.2, U6.41 (RESET_N/PME_CLEAR)
vbus_det: R29.2, U6.27 (VBUS_DET)

Notes on the sheet:
DECOUPLING CAPACITORS FOR ALL VOLTAGES
