R-Mutura/USB_HUB_ADAPTER/USB_HUB_ADAPTER/LAN_TO_USN2.kicad_sch

## KiCad design USB_HUB_ADAPTER/LAN_TO_USN2.kicad_sch (2022-11-24)

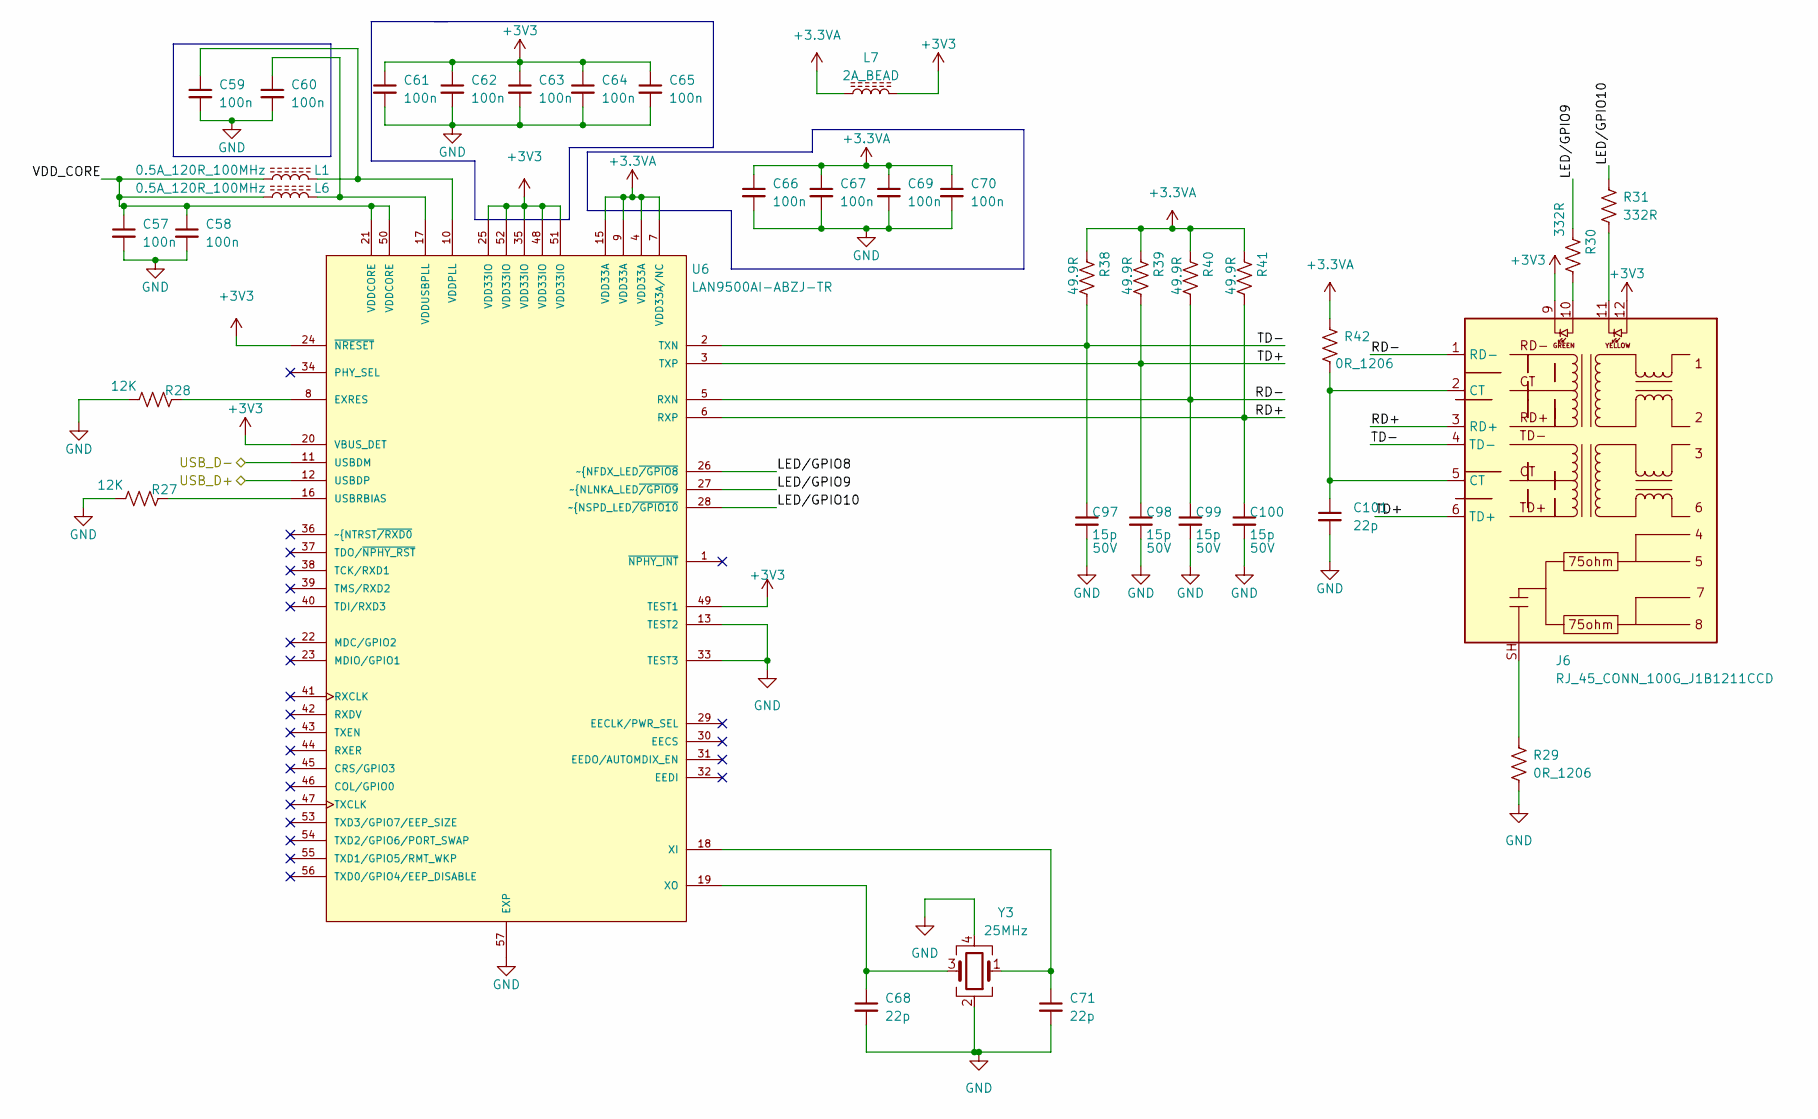
[picture p22: schematic LAN_TO_USN2.kicad_sch]

Parts:
C57, C58, C59, C60, C61, C62, C63, C64, C65, C66, C67, C69, C70: 100n; C_0402_1005Metric
C68, C71: 22p; C_0402_1005Metric
C97, C98, C99, C100: 15p; C_0402_1005Metric
C101: 22p; C_0805_2012Metric
J6: RJ_45_CONN_100G_J1B1211CCD; RJ45_CONN_J1B1211CCD
L1, L6: 0.5A_120R_100MHz; L_0402_1005Metric
L7: 2A_BEAD; L_0402_1005Metric
R27, R28: 12K; R_0402_1005Metric
R29, R42: 0R_1206; R_1206_3216Metric
R30, R31: 332R; R_0402_1005Metric
R38, R39, R40, R41: 49.9R; R_0402_1005Metric
U6: LAN9500AI-ABZJ-TR; LAN950X_QFN50P800X800X100-57N; PARTREV DS00001875C
Y3: 25MHz; Crystal_SMD_2520-4Pin_2.5x2.0mm

Connections:
+3.3VA: C66.1, C67.1, C69.1, C70.1, L7.1, R38.2, R39.2, R40.2, R41.2, R42.1, U6.4 (VDD33A), U6.7 (VDD33A/NC), U6.9 (VDD33A), U6.15 (VDD33A)
+3V3: C61.1, C62.1, C63.1, C64.1, C65.1, J6.9, J6.12, L7.2, U6.20 (VBUS_DET), U6.24 (~NRESET), U6.25 (VDD33IO), U6.35 (VDD33IO), U6.48 (VDD33IO), U6.49 (TEST1), U6.51 (VDD33IO), U6.52 (VDD33IO)
GND: C57.2, C58.2, C59.2, C60.2, C61.2, C62.2, C63.2, C64.2, C65.2, C66.2, C67.2, C68.2, C69.2, C70.2, C71.2, C97.2, C98.2, C99.2, C100.2, C101.2, R27.1, R28.1, R29.2, U6.13 (TEST2), U6.33 (TEST3), U6.57 (EXP), Y3.2, Y3.4
LED/GPIO8: U6.26 (~NFDX_LED~{/GPIO8)
LED/GPIO9: R30.2, U6.27 (~NLNKA_LED~{/GPIO9)
LED/GPIO10: R31.2, U6.28 (~NSPD_LED~{/GPIO10)
unnamed: C59.1, L1.2, U6.10 (VDDPLL)
unnamed: C60.1, L6.2, U6.17 (VDDUSBPLL)
unnamed: C68.1, U6.19 (XO), Y3.3
unnamed: C71.1, U6.18 (XI), Y3.1
unnamed: C101.1, J6.2 (CT), J6.5 (CT), R42.2
unnamed: J6.10, R30.1
unnamed: J6.11, R31.1
unnamed: J6.SH, R29.1
unnamed: R27.2, U6.16 (USBRBIAS)
unnamed: R28.2, U6.8 (EXRES)
RD+: C100.1, J6.3 (RD+), R41.1, U6.6 (RXP)
RD-: C99.1, J6.1 (RD-), R40.1, U6.5 (RXN)
TD+: C98.1, J6.6 (TD+), R39.1, U6.3 (TXP)
TD-: C97.1, J6.4 (TD-), R38.1, U6.2 (TXN)
USB_D+: U6.12 (USBDP)
USB_D-: U6.11 (USBDM)
VDD_CORE: C57.1, C58.1, L1.1, L6.1, U6.21 (VDDCORE), U6.50 (VDDCORE)
