R-Mutura/USB_HUB_ADAPTER/USB_HUB_ADAPTER/PD_USB_C_SINK_CONTROLLER.kicad_sch

## KiCad design USB_HUB_ADAPTER/PD_USB_C_SINK_CONTROLLER.kicad_sch (2022-11-23)

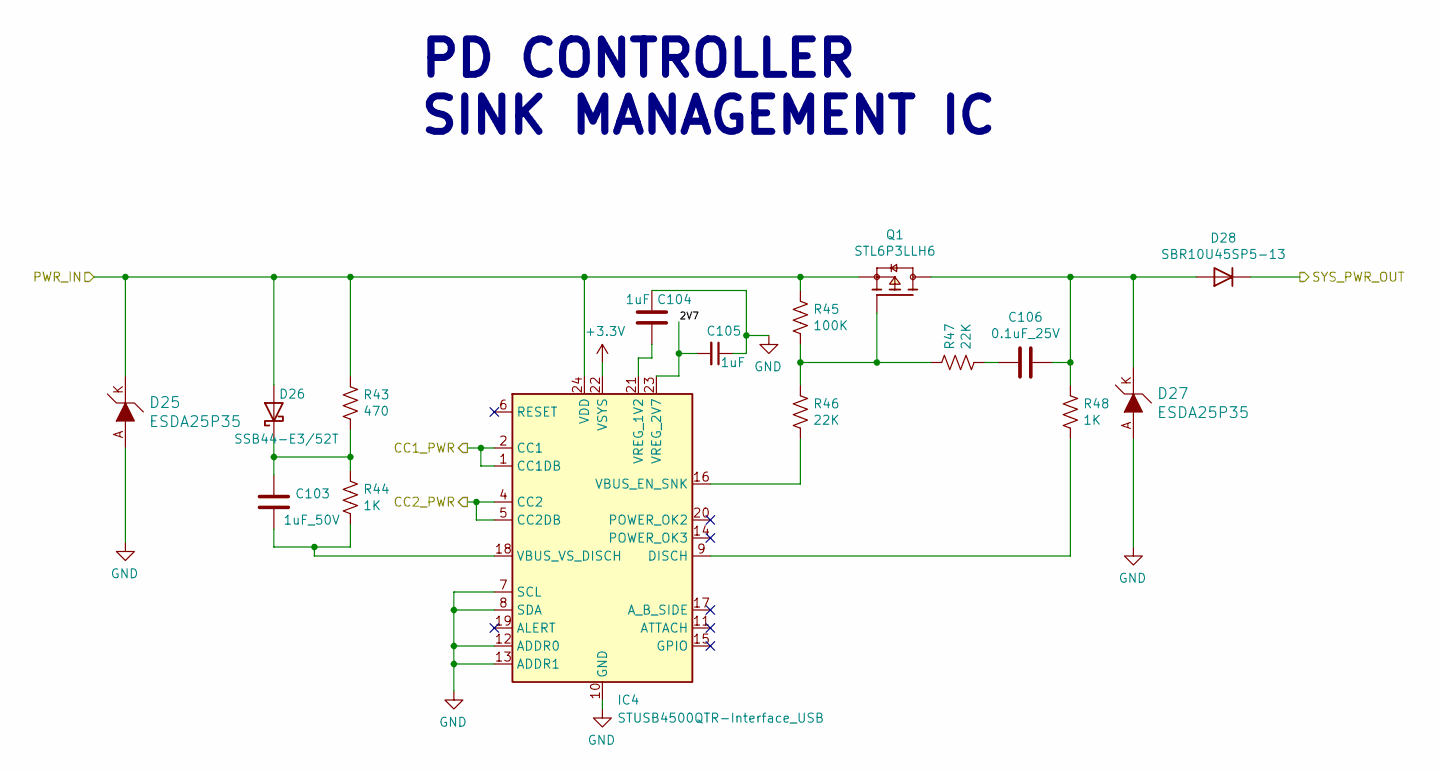
[picture p23: schematic PD_USB_C_SINK_CONTROLLER.kicad_sch]

Parts:
C103: 1uF_50V; C_0402_1005Metric
C104, C105: 1uF; C_0402_1005Metric
C106: 0.1uF_25V; C_0402_1005Metric
D25: ESDA25P35; SOD-523; MPN ESD5Z3.3T1G; Digi-Key_PN ESD5Z3.3T1GOSCT-ND
D26: SSB44-E3/52T; D_SMB
D27: ESDA25P35; SOD-523; MPN ESD5Z3.3T1G
D28: SBR10U45SP5-13; D_PowerDI-5
IC4: STUSB4500QTR-Interface_USB; QFN-24-1EP_4x4mm_P0.5mm_EP2.7x2.7mm
Q1: STL6P3LLH6
R43: 470; R_0603_1608Metric
R44, R48: 1K; R_0603_1608Metric
R45: 100K; R_0603_1608Metric
R46, R47: 22K; R_0603_1608Metric

Connections:
2V7: C105.2, IC4.23 (VREG_2V7)
+3.3V: IC4.22 (VSYS)
CC1_PWR: IC4.1 (CC1DB), IC4.2 (CC1)
CC2_PWR: IC4.4 (CC2), IC4.5 (CC2DB)
GND: C104.1, C105.1, D25.A, D27.A, IC4.7 (SCL), IC4.8 (SDA), IC4.10 (GND), IC4.12 (ADDR0), IC4.13 (ADDR1), IC4.25 (GND)
unnamed: C103.1, D26.1 (K), R43.2, R44.1
unnamed: C103.2, IC4.18 (VBUS_VS_DISCH), R44.2
unnamed: C104.2, IC4.21 (VREG_1V2)
unnamed: C106.1, R47.2
unnamed: C106.2, D27.K, D28.2 (A), Q1.5 (D), R48.1
unnamed: IC4.9 (DISCH), R48.2
unnamed: IC4.16 (VBUS_EN_SNK), R46.2
unnamed: Q1.4 (G), R45.2, R46.1, R47.1
PWR_IN: D25.K, D26.2 (A), IC4.24 (VDD), Q1.1 (S), Q1.2, Q1.3, R43.1, R45.1
SYS_PWR_OUT: D28.1 (K)

Notes on the sheet:
PD CONTROLLER SINK MANAGEMENT IC
