R-Mutura/USB_HUB_ADAPTER/USB_HUB_ADAPTER/POWER_SELECTION_PATH.kicad_sch

## KiCad design USB_HUB_ADAPTER/POWER_SELECTION_PATH.kicad_sch (2022-11-23)

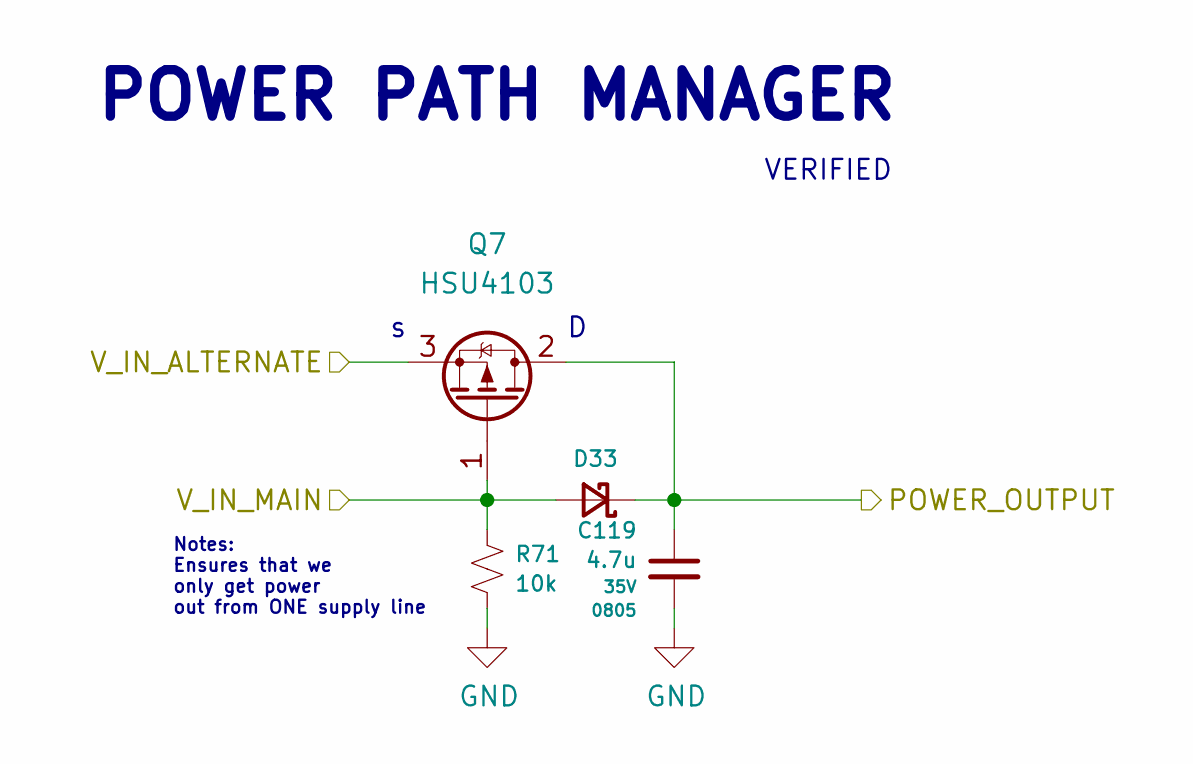
[picture p24: schematic POWER_SELECTION_PATH.kicad_sch]

Parts:
C119: 4.7u; C_0603_1608Metric; Voltage 35V
D33: D_Schottky_Small; D_SMA
Q7: HSU4103; TO-252-3_tabpin-2
R71: 10k; R_0603_1608Metric

Connections:
GND: C119.2, R71.2
POWER_OUTPUT: C119.1, D33.1 (K), Q7.2 (D)
V_IN_ALTERNATE: Q7.3 (S)
V_IN_MAIN: D33.2 (A), Q7.1 (G), R71.1

Notes on the sheet:
POWER PATH MANAGER
VERIFIED
Notes: Ensures that we only get power out from ONE supply line
