R-Mutura/USB_HUB_ADAPTER/USB_HUB_ADAPTER/SD_TO_USB_PHY_USB2240.kicad_sch

## KiCad design USB_HUB_ADAPTER/SD_TO_USB_PHY_USB2240.kicad_sch (2022-11-23)

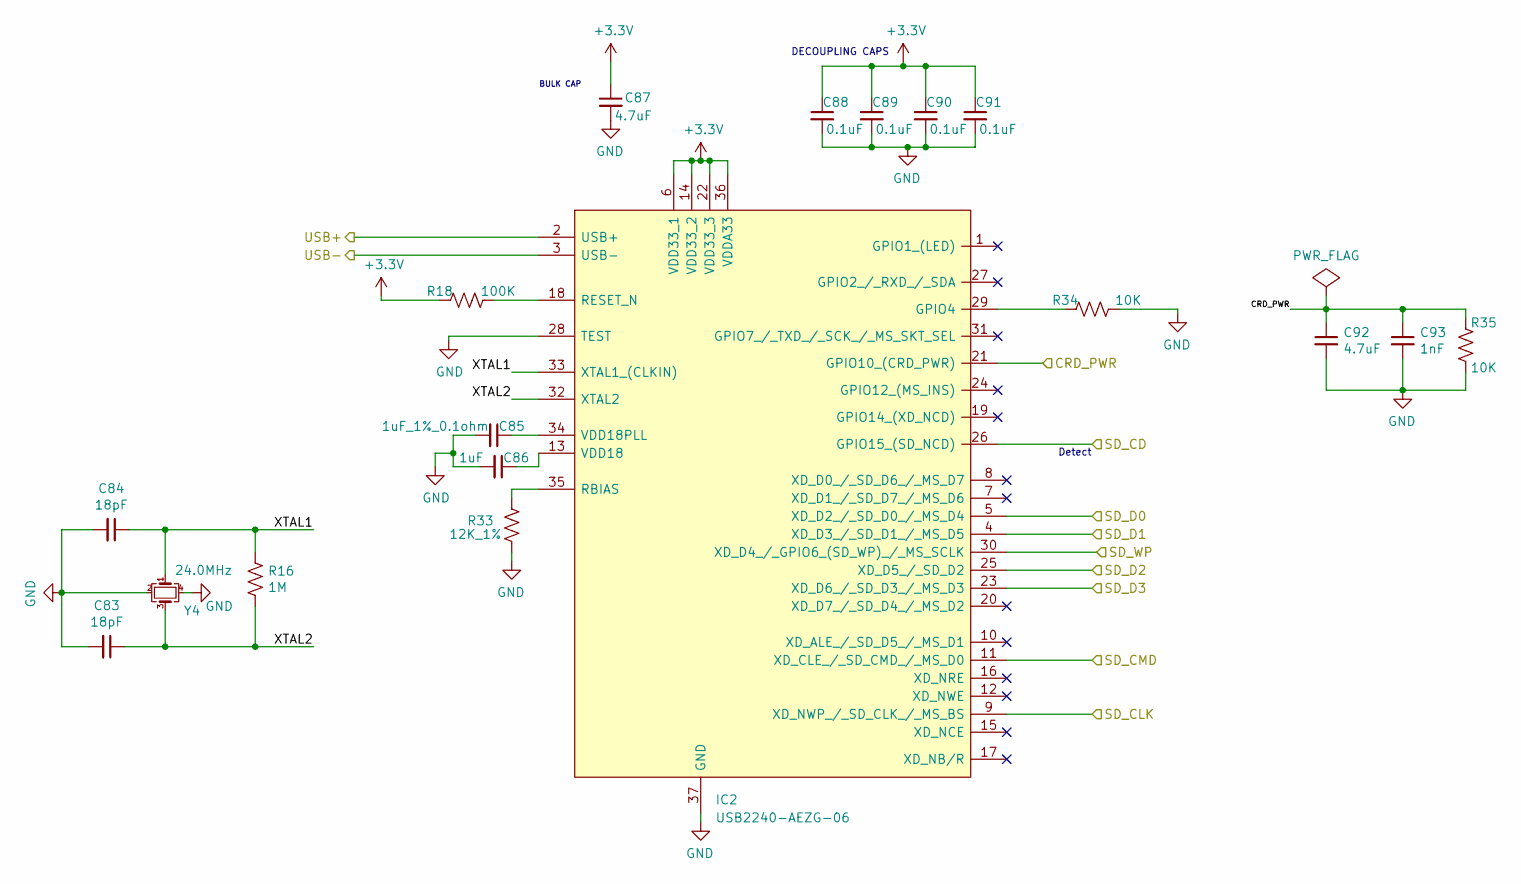
[picture p25: schematic SD_TO_USB_PHY_USB2240.kicad_sch]

Parts:
C83, C84: 18pF; C_0402_1005Metric
C85: 1uF_1%_0.1ohm; C_0603_1608Metric
C86: 1uF; C_0603_1608Metric
C87, C92: 4.7uF; C_0603_1608Metric
C88, C89, C90, C91: 0.1uF; C_0402_1005Metric
C93: 1nF; C_0402_1005Metric
IC2: USB2240-AEZG-06; QFN-36-1EP_6x6mm_P0.5mm_EP3.7x3.7mm; Mouser Part Number 886-USB2240-AEZG-06
R16: 1M; R_0402_1005Metric
R18: 100K; R_0402_1005Metric
R33: 12K_1%; R_0402_1005Metric
R34, R35: 10K; R_0402_1005Metric
Y4: 24.0MHz; Crystal_SMD_2016-4Pin_2.0x1.6mm

Connections:
+3.3V: C87.1, C88.1, C89.1, C90.1, C91.1, IC2.6 (VDD33_1), IC2.14 (VDD33_2), IC2.22 (VDD33_3), IC2.36 (VDDA33), R18.1
CRD_PWR: C92.1, C93.1, IC2.21 (GPIO10_(CRD_PWR)), R35.2
GND: C83.2, C84.2, C85.2, C86.2, C87.2, C88.2, C89.2, C90.2, C91.2, C92.2, C93.2, IC2.28 (TEST), IC2.37 (GND), R33.2, R34.1, R35.1, Y4.2, Y4.4
unnamed: C85.1, IC2.34 (VDD18PLL)
unnamed: C86.1, IC2.13 (VDD18)
unnamed: IC2.18 (RESET_N), R18.2
unnamed: IC2.29 (GPIO4), R34.2
unnamed: IC2.35 (RBIAS), R33.1
SD_CD: IC2.26 (GPIO15_(SD_NCD))
SD_CLK: IC2.9 (XD_NWP_/_SD_CLK_/_MS_BS)
SD_CMD: IC2.11 (XD_CLE_/_SD_CMD_/_MS_D0)
SD_D0: IC2.5 (XD_D2_/_SD_D0_/_MS_D4)
SD_D1: IC2.4 (XD_D3_/_SD_D1_/_MS_D5)
SD_D2: IC2.25 (XD_D5_/_SD_D2)
SD_D3: IC2.23 (XD_D6_/_SD_D3_/_MS_D3)
SD_WP: IC2.30 (XD_D4_/_GPIO6_(SD_WP)_/_MS_SCLK)
USB+: IC2.2 (USB+)
USB-: IC2.3 (USB-)
XTAL1: C84.1, IC2.33 (XTAL1_(CLKIN)), R16.1, Y4.1
XTAL2: C83.1, IC2.32 (XTAL2), R16.2, Y4.3

Notes on the sheet:
Detect
DECOUPLING CAPS
BULK CAP
