R-Mutura/USB_HUB_ADAPTER/USB_HUB_ADAPTER/USB_C_HUB_CTRL_USB7206.kicad_sch

## KiCad design USB_HUB_ADAPTER/USB_C_HUB_CTRL_USB7206.kicad_sch (2022-11-23)

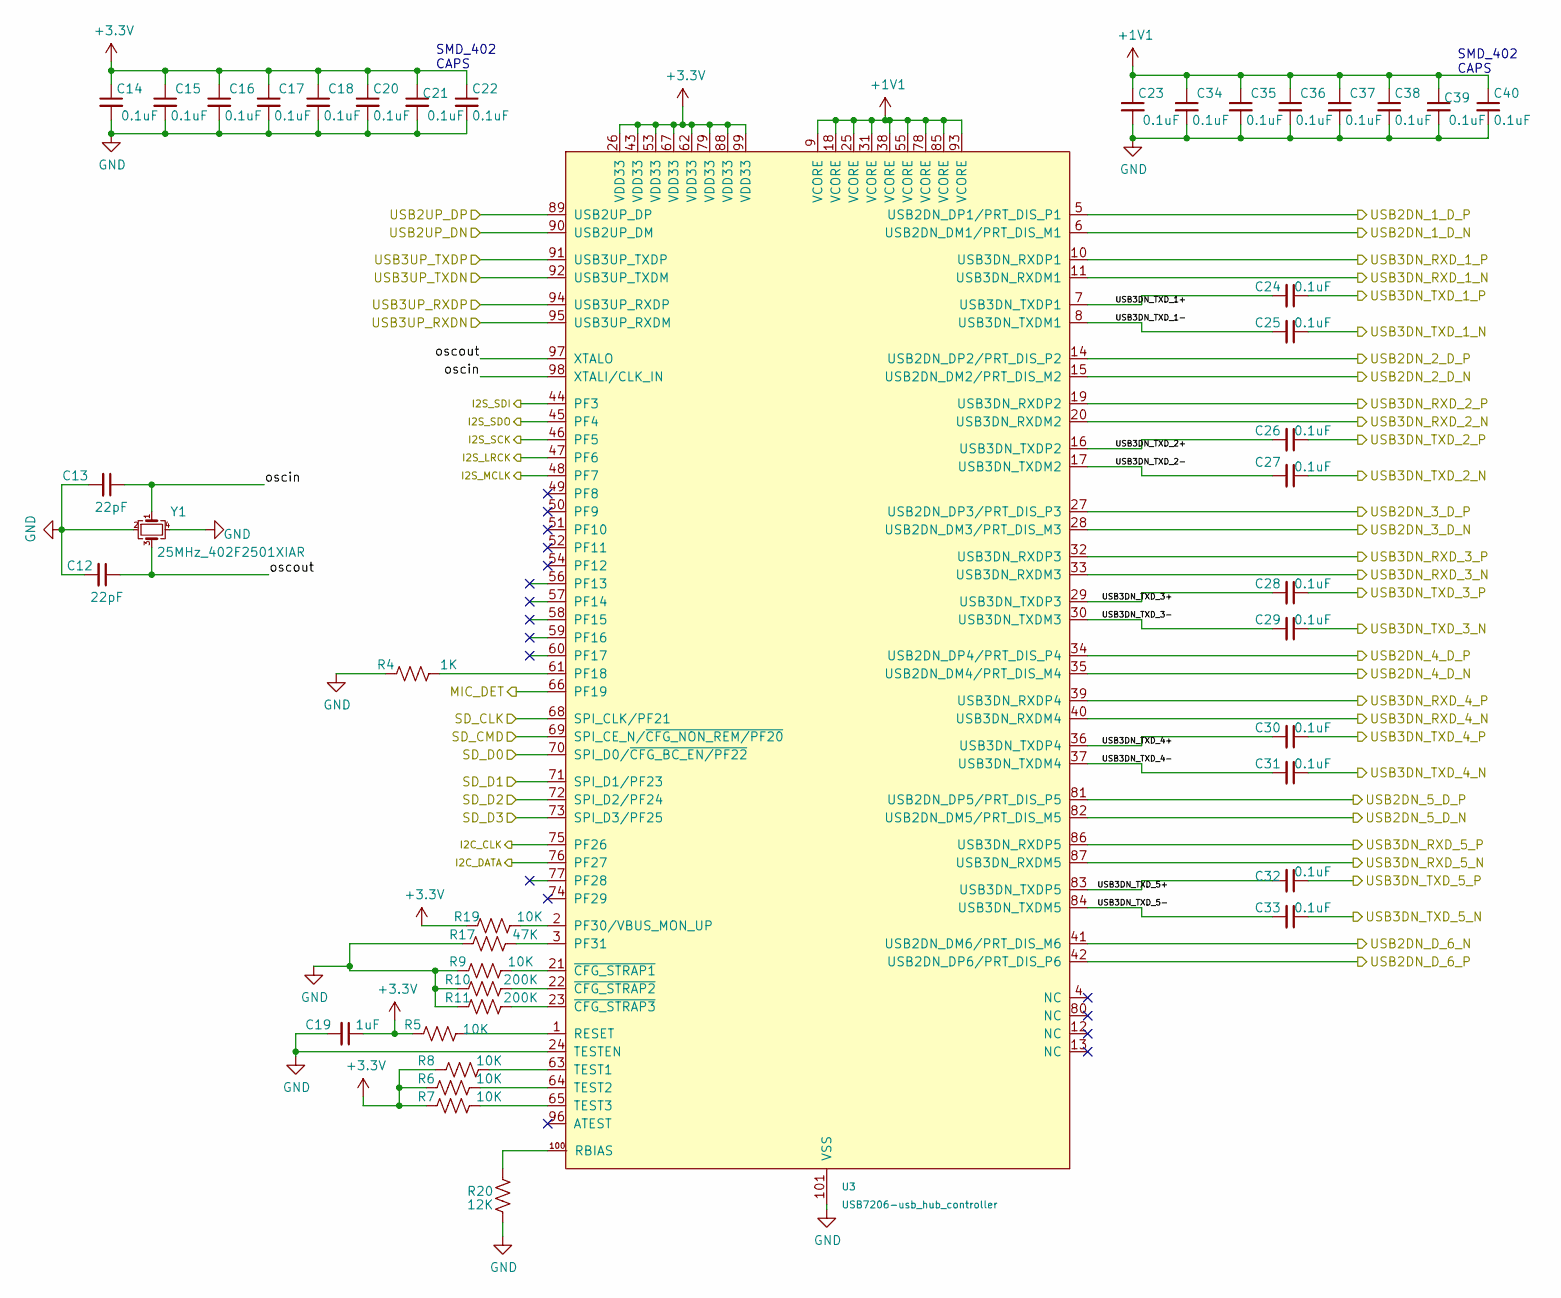
[picture p26: schematic USB_C_HUB_CTRL_USB7206.kicad_sch]

Parts:
C12, C13: 22pF; C_0402_1005Metric
C14, C15, C16, C17, C18, C20, C21, C22, C23, C24, C25, C26, C27, C28, C29, C30, C31, C32, C33, C34, C35, C36, C37, C38, C39, C40: 0.1uF; C_0402_1005Metric
C19: 1uF; C_0402_1005Metric
R4: 1K; R_0402_1005Metric
R5, R6, R7, R8, R9, R19: 10K; R_0402_1005Metric
R10, R11: 200K; R_0402_1005Metric
R17: 47K; R_0402_1005Metric
R20: 12K; R_0402_1005Metric
U3: USB7206-usb_hub_controller; QFN-100_40P1200X1200X90-101N-D
Y1: 25MHz_402F2501XIAR; Crystal_SMD_2016-4Pin_2.0x1.6mm

Connections:
+1V1: C23.1, C34.1, C35.1, C36.1, C37.1, C38.1, C39.1, C40.1, U3.9 (VCORE), U3.18 (VCORE), U3.25 (VCORE), U3.31 (VCORE), U3.38 (VCORE), U3.55 (VCORE), U3.78 (VCORE), U3.85 (VCORE), U3.93 (VCORE)
+3.3V: C14.1, C15.1, C16.1, C17.1, C18.1, C19.1, C20.1, C21.1, C22.1, R5.2, R6.2, R7.2, R8.2, R19.2, U3.26 (VDD33), U3.43 (VDD33), U3.53 (VDD33), U3.62 (VDD33), U3.67 (VDD33), U3.79 (VDD33), U3.88 (VDD33), U3.99 (VDD33)
GND: C12.2, C13.2, C14.2, C15.2, C16.2, C17.2, C18.2, C19.2, C20.2, C21.2, C22.2, C23.2, C34.2, C35.2, C36.2, C37.2, C38.2, C39.2, C40.2, R4.2, R9.2, R10.2, R11.2, R17.2, R20.2, U3.24 (TESTEN), U3.101 (VSS), Y1.2, Y1.4
I2C_CLK: U3.75 (PF26)
I2C_DATA: U3.76 (PF27)
I2S_LRCK: U3.47 (PF6)
I2S_MCLK: U3.48 (PF7)
I2S_SCK: U3.46 (PF5)
I2S_SDI: U3.44 (PF3)
I2S_SDO: U3.45 (PF4)
MIC_DET: U3.66 (PF19)
unnamed: R4.1, U3.61 (PF18)
unnamed: R5.1, U3.1 (RESET)
unnamed: R6.1, U3.64 (TEST2)
unnamed: R7.1, U3.65 (TEST3)
unnamed: R8.1, U3.63 (TEST1)
unnamed: R9.1, U3.21 (~CFG_STRAP1)
unnamed: R10.1, U3.22 (~CFG_STRAP2)
unnamed: R11.1, U3.23 (~CFG_STRAP3)
unnamed: R17.1, U3.3 (PF31)
unnamed: R19.1, U3.2 (PF30/VBUS_MON_UP)
unnamed: R20.1, U3.100 (RBIAS)
SD_CLK: U3.68 (SPI_CLK/PF21)
SD_CMD: U3.69 (SPI_CE_N/~CFG_NON_REM/PF20)
SD_D0: U3.70 (SPI_D0/~CFG_BC_EN/PF22)
SD_D1: U3.71 (SPI_D1/PF23)
SD_D2: U3.72 (SPI_D2/PF24)
SD_D3: U3.73 (SPI_D3/PF25)
USB2DN_1_D_N: U3.6 (USB2DN_DM1/PRT_DIS_M1)
USB2DN_1_D_P: U3.5 (USB2DN_DP1/PRT_DIS_P1)
USB2DN_2_D_N: U3.15 (USB2DN_DM2/PRT_DIS_M2)
USB2DN_2_D_P: U3.14 (USB2DN_DP2/PRT_DIS_P2)
USB2DN_3_D_N: U3.28 (USB2DN_DM3/PRT_DIS_M3)
USB2DN_3_D_P: U3.27 (USB2DN_DP3/PRT_DIS_P3)
USB2DN_4_D_N: U3.35 (USB2DN_DM4/PRT_DIS_M4)
USB2DN_4_D_P: U3.34 (USB2DN_DP4/PRT_DIS_P4)
USB2DN_5_D_N: U3.82 (USB2DN_DM5/PRT_DIS_M5)
USB2DN_5_D_P: U3.81 (USB2DN_DP5/PRT_DIS_P5)
USB2DN_D_6_N: U3.41 (USB2DN_DM6/PRT_DIS_M6)
USB2DN_D_6_P: U3.42 (USB2DN_DP6/PRT_DIS_P6)
USB2UP_DN: U3.90 (USB2UP_DM)
USB2UP_DP: U3.89 (USB2UP_DP)
USB3DN_RXD_1_N: U3.11 (USB3DN_RXDM1)
USB3DN_RXD_1_P: U3.10 (USB3DN_RXDP1)
USB3DN_RXD_2_N: U3.20 (USB3DN_RXDM2)
USB3DN_RXD_2_P: U3.19 (USB3DN_RXDP2)
USB3DN_RXD_3_N: U3.33 (USB3DN_RXDM3)
USB3DN_RXD_3_P: U3.32 (USB3DN_RXDP3)
USB3DN_RXD_4_N: U3.40 (USB3DN_RXDM4)
USB3DN_RXD_4_P: U3.39 (USB3DN_RXDP4)
USB3DN_RXD_5_N: U3.87 (USB3DN_RXDM5)
USB3DN_RXD_5_P: U3.86 (USB3DN_RXDP5)
USB3DN_TXD_1+: C24.2, U3.7 (USB3DN_TXDP1)
USB3DN_TXD_1-: C25.2, U3.8 (USB3DN_TXDM1)
USB3DN_TXD_1_N: C25.1
USB3DN_TXD_1_P: C24.1
USB3DN_TXD_2+: C26.2, U3.16 (USB3DN_TXDP2)
USB3DN_TXD_2-: C27.2, U3.17 (USB3DN_TXDM2)
USB3DN_TXD_2_N: C27.1
USB3DN_TXD_2_P: C26.1
USB3DN_TXD_3+: C28.2, U3.29 (USB3DN_TXDP3)
USB3DN_TXD_3-: C29.2, U3.30 (USB3DN_TXDM3)
USB3DN_TXD_3_N: C29.1
USB3DN_TXD_3_P: C28.1
USB3DN_TXD_4+: C30.2, U3.36 (USB3DN_TXDP4)
USB3DN_TXD_4-: C31.2, U3.37 (USB3DN_TXDM4)
USB3DN_TXD_4_N: C31.1
USB3DN_TXD_4_P: C30.1
USB3DN_TXD_5+: C32.2, U3.83 (USB3DN_TXDP5)
USB3DN_TXD_5-: C33.2, U3.84 (USB3DN_TXDM5)
USB3DN_TXD_5_N: C33.1
USB3DN_TXD_5_P: C32.1
USB3UP_RXDN: U3.95 (USB3UP_RXDM)
USB3UP_RXDP: U3.94 (USB3UP_RXDP)
USB3UP_TXDN: U3.92 (USB3UP_TXDM)
USB3UP_TXDP: U3.91 (USB3UP_TXDP)
oscin: C13.1, U3.98 (XTALI/CLK_IN), Y1.1
oscout: C12.1, U3.97 (XTALO), Y1.3

Notes on the sheet:
SMD_402 CAPS
