R-Mutura/USB_HUB_ADAPTER/USB_HUB_ADAPTER/USB_HUB_ADAPTER.kicad_sch

## KiCad design USB_HUB_ADAPTER/USB_HUB_ADAPTER.kicad_sch (2022-11-24)

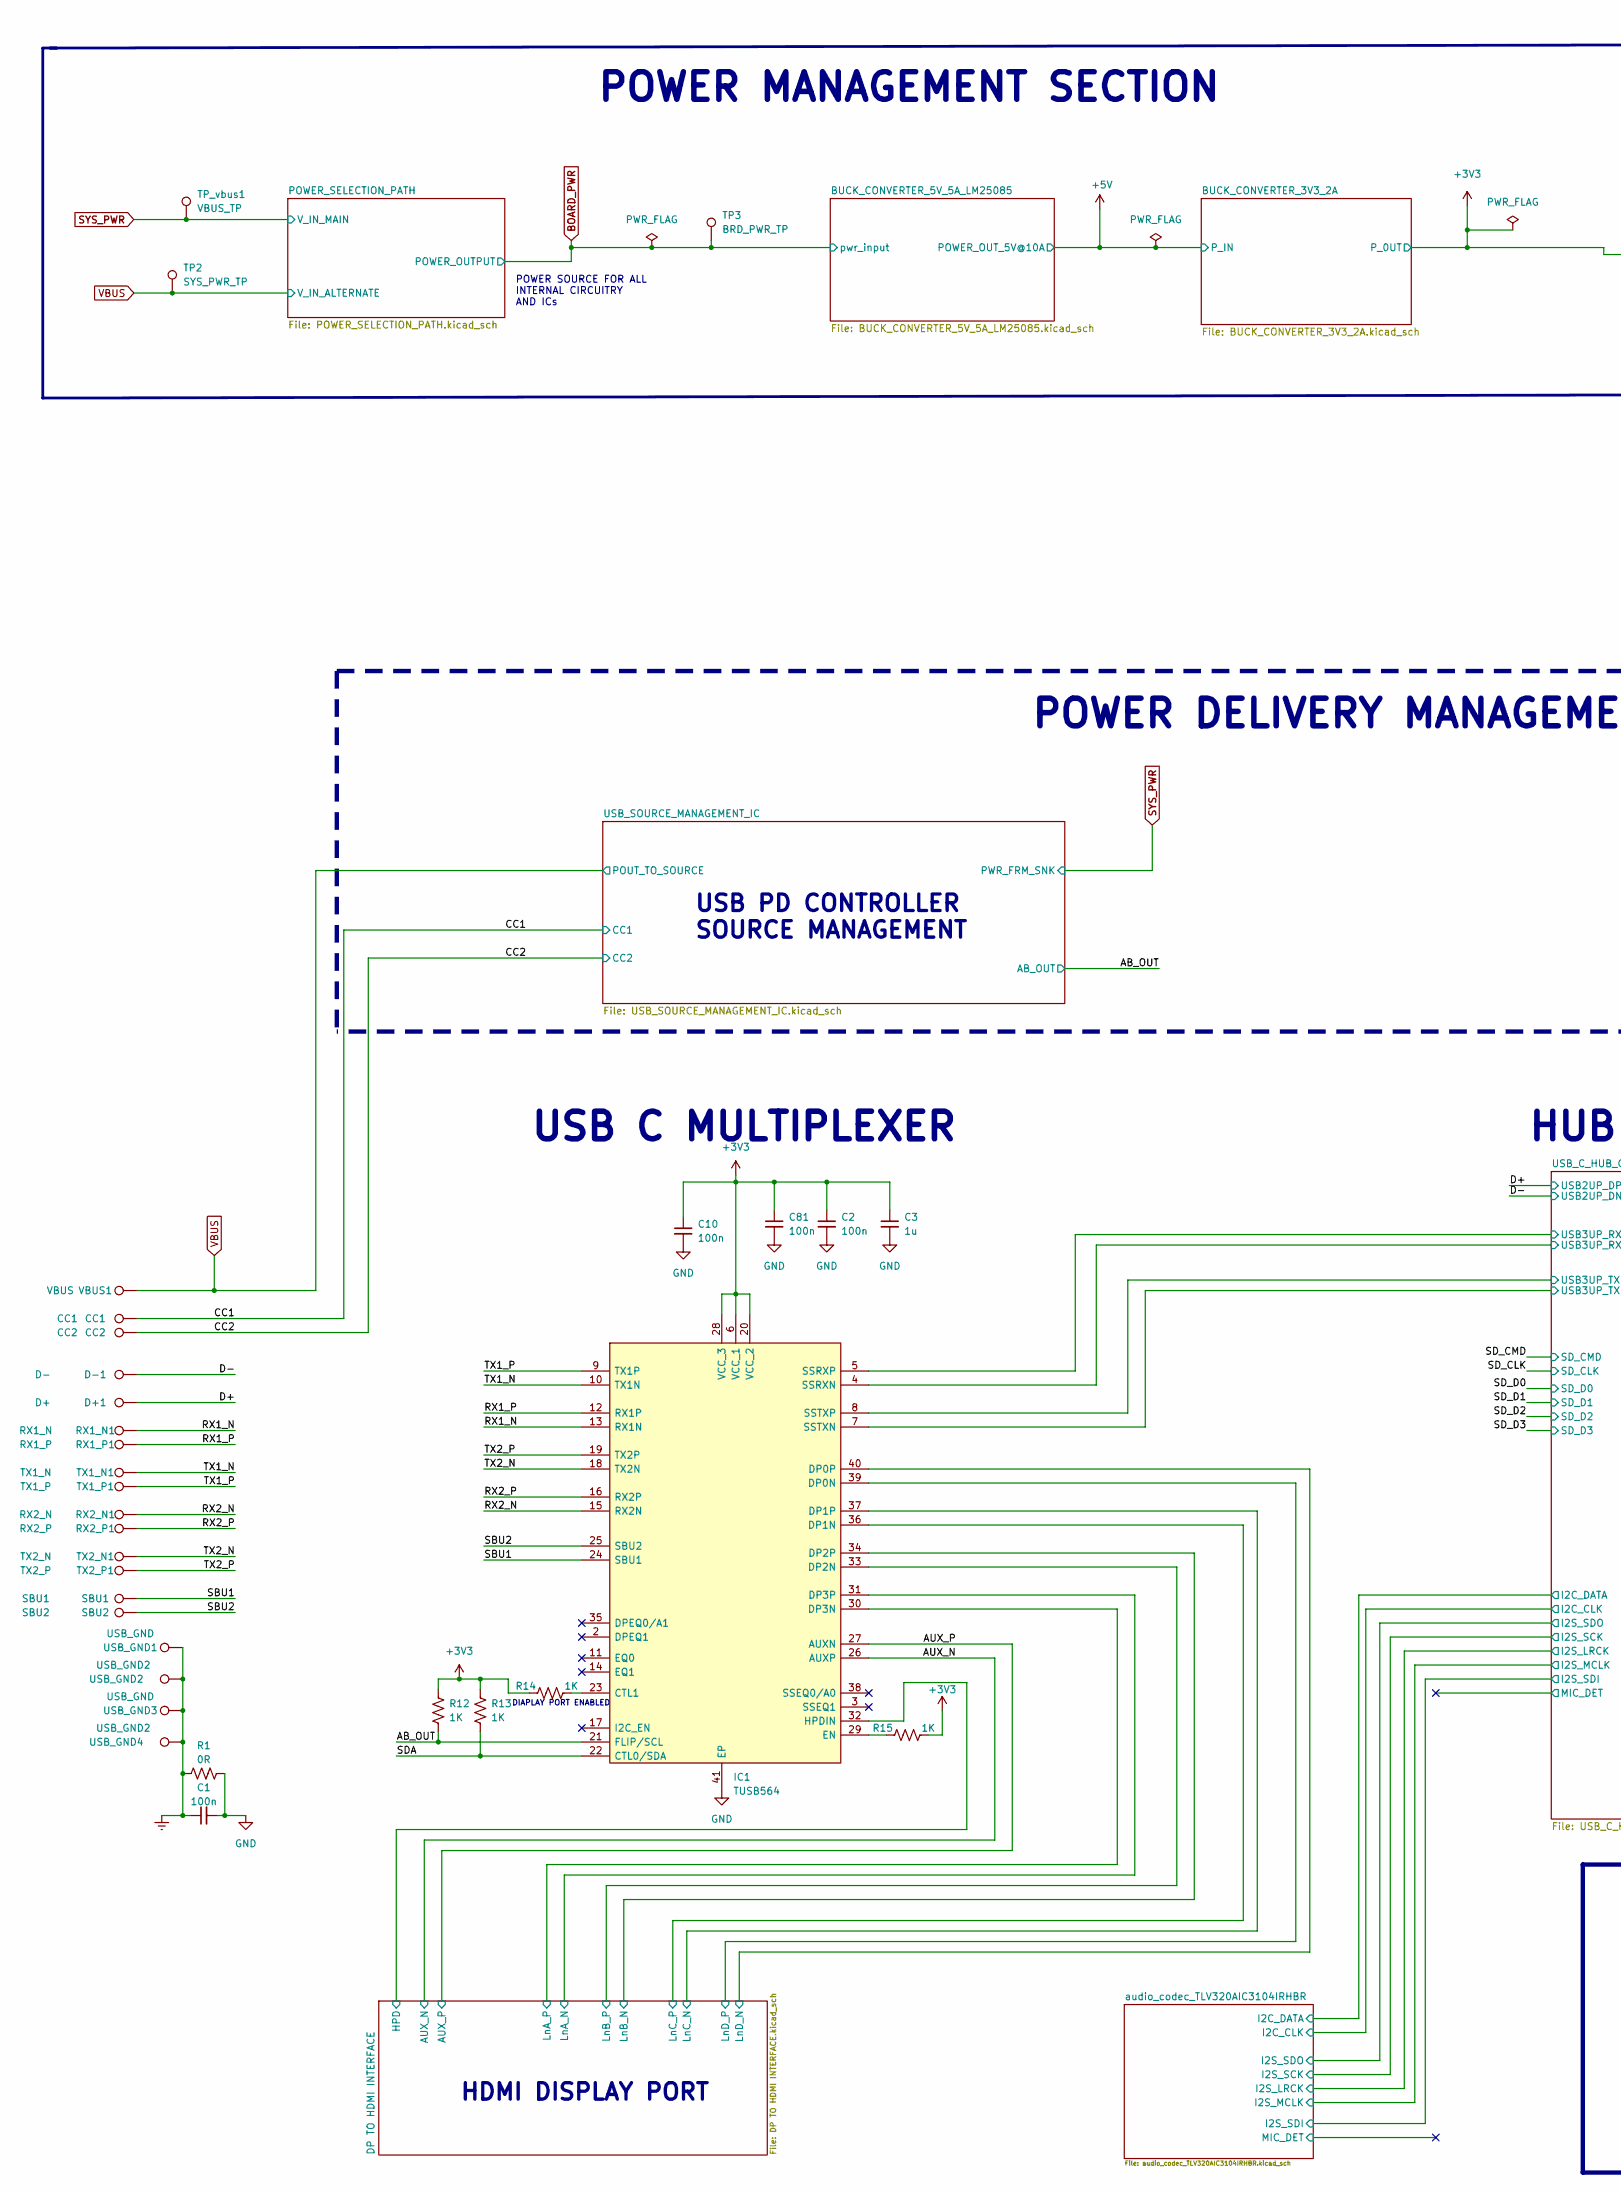
[picture p27: schematic USB_HUB_ADAPTER.kicad_sch, part in row 1, column 1]

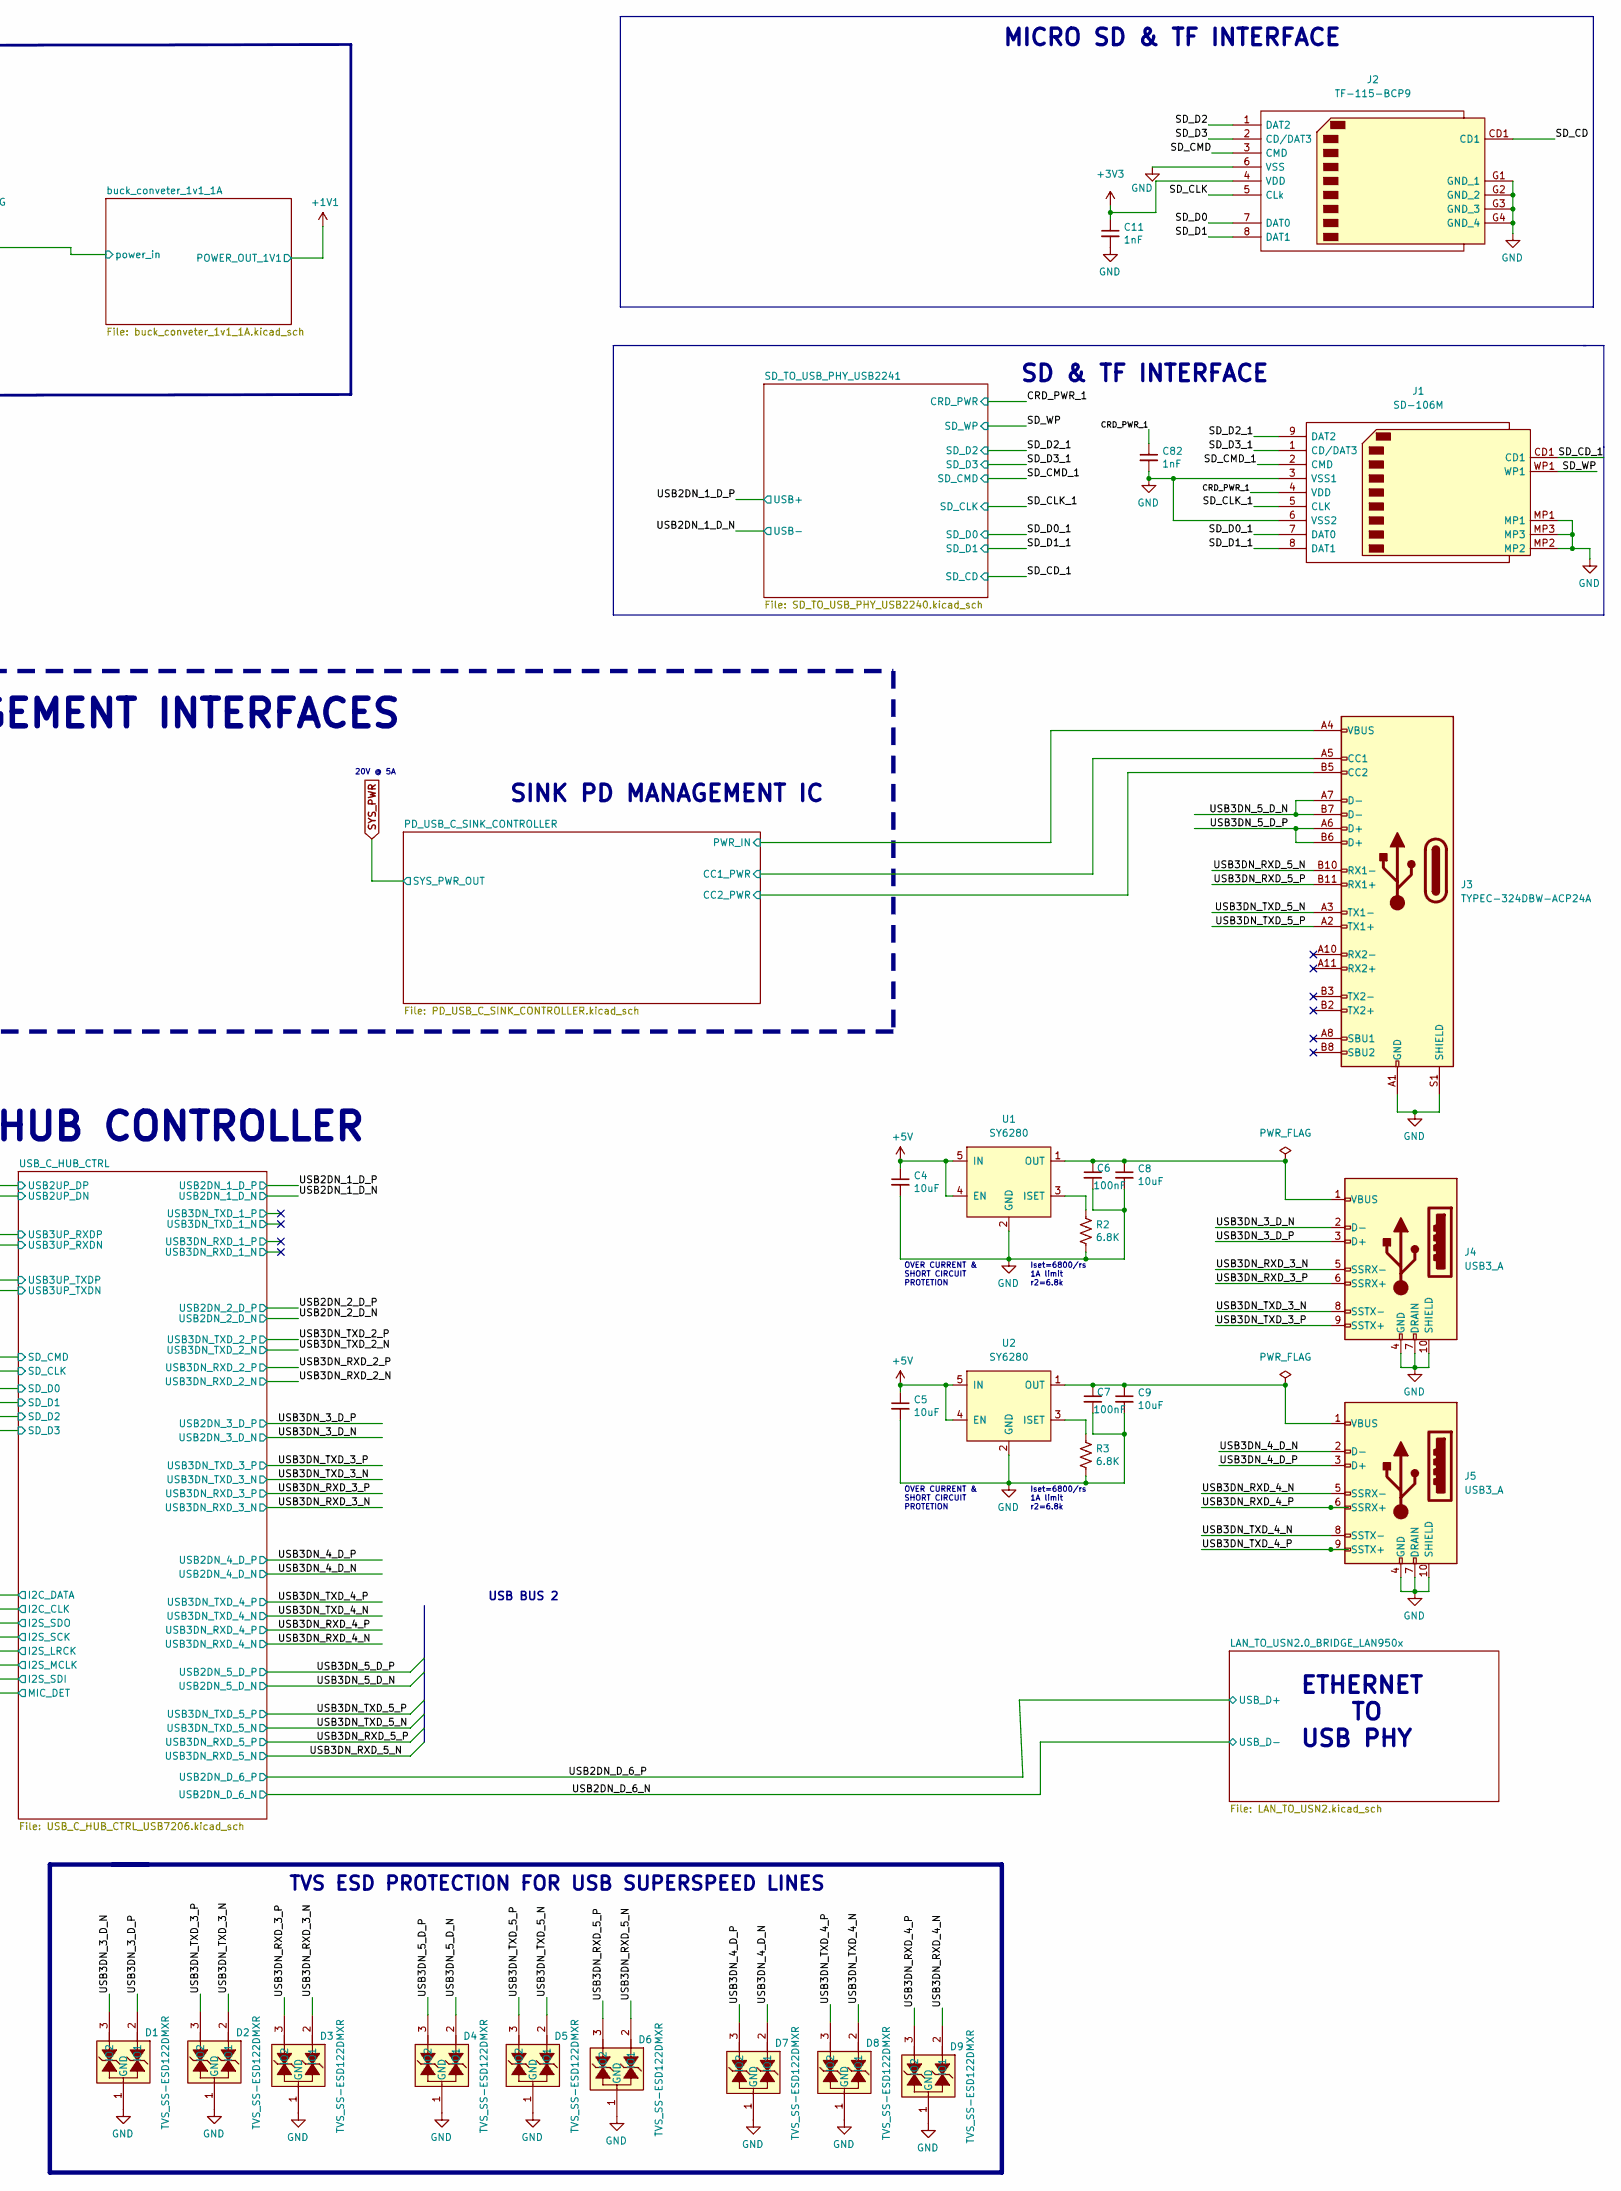
[picture p28: schematic USB_HUB_ADAPTER.kicad_sch, part in row 1, column 2]

Parts:
C1: 100n; C_0805_2012Metric
C2, C10, C81: 100n; C_0402_1005Metric
C3: 1u; C_0402_1005Metric
C4, C5, C8, C9: 10uF; C_0603_1608Metric
C6, C7: 100nF; C_0402_1005Metric
C11, C82: 1nF; C_0402_1005Metric
CC1: CC1; TP_PAD_1.5x0.8
CC2: CC2; TP_PAD_1.5x0.8
D1, D2, D3, D4, D5, D6, D7, D8, D9: TVS_SS-ESD122DMXR; DMX0003A; Mouser Part Number 595-ESD122DMXR
D+1: D+; TP_PAD_1.5x0.8
D-1: D-; TP_PAD_1.5x0.8
IC1: TUSB564; Mouser Part Number 595-TUSB564IRNQT
J1: SD-106M; sd_card_SD106M; Manufacturer_Part_Number SD-106M
J2: TF-115-BCP9; sd_tf_card_TF115BCP9; Manufacturer_Part_Number TF-115-BCP9
J3: TYPEC-324DBW-ACP24A; GCT_USB4056-03-A_REVA
J4, J5: USB3_A; usb_A_3.0_U231091N3GRC105
R1: 0R; R_0603_1608Metric
R2, R3: 6.8K; R_0603_1608Metric
R12, R13, R14, R15: 1K; R_0402_1005Metric
RX1_N1: RX1_N; TP_PAD_1.5x0.8
RX1_P1: RX1_P; TP_PAD_1.5x0.8
RX2_N1: RX2_N; TP_PAD_1.5x0.8
RX2_P1: RX2_P; TP_PAD_1.5x0.8
SBU1: SBU1; TP_PAD_1.5x0.8
SBU2: SBU2; TP_PAD_1.5x0.8
TP2: SYS_PWR_TP; TestPoint_Pad_D0.9mm
TP3: BRD_PWR_TP; TestPoint_Pad_D0.9mm
TP_vbus1: VBUS_TP; TestPoint_Pad_D0.9mm
TX1_N1: TX1_N; TP_PAD_1.5x0.8
TX1_P1: TX1_P; TP_PAD_1.5x0.8
TX2_N1: TX2_N; TP_PAD_1.5x0.8
TX2_P1: TX2_P; TP_PAD_1.5x0.8
U1, U2: SY6280; SOT-23-5
USB_GND1, USB_GND3: USB_GND; TP_PAD_1.5x0.8
USB_GND2, USB_GND4: USB_GND2; TP_PAD_1.5x0.8
VBUS1: VBUS; TP_PAD_1.5x0.8

Connections:
+3V3: C2.1, C3.1, C10.1, C11.1, C81.1, IC1.6 (VCC_1), IC1.20 (VCC_2), IC1.28 (VCC_3), J2.4 (VDD), R12.1, R13.1, R14.1, R15.2
+5V: C4.1, C5.1, U1.4 (EN), U1.5 (IN), U2.4 (EN), U2.5 (IN)
AB_OUT: IC1.21 (FLIP/SCL), R12.2
AUX_N: IC1.26 (AUXP)
AUX_P: IC1.27 (AUXN)
BOARD_PWR: TP3.1
CC1: CC1.1
CC1_PWR: J3.A5 (CC1)
CC2: CC2.1
CC2_PWR: J3.B5 (CC2)
CRD_PWR_1: C82.1, J1.4 (VDD)
D+: D+1.1
D-: D-1.1
Earth: C1.1, R1.1, USB_GND1.1, USB_GND2.1, USB_GND3.1, USB_GND4.1
GND: C1.2, C2.2, C3.2, C4.2, C5.2, C6.2, C7.2, C8.2, C9.2, C10.2, C11.2, C81.2, C82.2, D1.1 (GND), D2.1 (GND), D3.1 (GND), D4.1 (GND), D5.1 (GND), D6.1 (GND), D7.1 (GND), D8.1 (GND), D9.1 (GND), IC1.41 (EP), J1.3 (VSS1), J1.6 (VSS2), J1.MP1, J1.MP2, J1.MP3, J2.6 (VSS), J2.G1 (GND_1), J2.G2 (GND_2), J2.G3 (GND_3), J2.G4 (GND_4), J3.A1 (GND), J3.A12 (GND), J3.B1 (GND), J3.B12 (GND), J3.S1 (SHIELD), J4.4 (GND), J4.7 (DRAIN), J4.10 (SHIELD), J5.4 (GND), J5.7 (DRAIN), J5.10 (SHIELD), R1.2, R2.2, R3.2, U1.2 (GND), U2.2 (GND)
HPD: IC1.32 (HPDIN)
LnA_N: IC1.31 (DP3P)
LnA_P: IC1.30 (DP3N)
LnB_N: IC1.34 (DP2P)
LnB_P: IC1.33 (DP2N)
LnC_N: IC1.37 (DP1P)
LnC_P: IC1.36 (DP1N)
LnD_N: IC1.40 (DP0P)
LnD_P: IC1.39 (DP0N)
unnamed: C6.1, C8.1, J4.1 (VBUS), U1.1 (OUT)
unnamed: C7.1, C9.1, J5.1 (VBUS), U2.1 (OUT)
unnamed: IC1.23 (CTL1), R14.2
unnamed: IC1.29 (EN), R15.1
unnamed: R2.1, U1.3 (ISET)
unnamed: R3.1, U2.3 (ISET)
PWR_IN: J3.A4 (VBUS), J3.A9 (VBUS), J3.B4 (VBUS), J3.B9 (VBUS)
RX1_N: IC1.13 (RX1N), RX1_N1.1
RX1_P: IC1.12 (RX1P), RX1_P1.1
RX2_N: IC1.15 (RX2N), RX2_N1.1
RX2_P: IC1.16 (RX2P), RX2_P1.1
SBU1: IC1.24 (SBU1), SBU1.1
SBU2: IC1.25 (SBU2), SBU2.1
SDA: IC1.22 (CTL0/SDA), R13.2
SD_CD: J2.CD1
SD_CD_1: J1.CD1
SD_CLK: J2.5 (CLk)
SD_CLK_1: J1.5 (CLK)
SD_CMD: J2.3 (CMD)
SD_CMD_1: J1.2 (CMD)
SD_D0: J2.7 (DAT0)
SD_D0_1: J1.7 (DAT0)
SD_D1: J2.8 (DAT1)
SD_D1_1: J1.8 (DAT1)
SD_D2: J2.1 (DAT2)
SD_D2_1: J1.9 (DAT2)
SD_D3: J2.2 (CD/DAT3)
SD_D3_1: J1.1 (CD/DAT3)
SD_WP: J1.WP1
SYS_PWR: TP_vbus1.1
TX1_N: IC1.10 (TX1N), TX1_N1.1
TX1_P: IC1.9 (TX1P), TX1_P1.1
TX2_N: IC1.18 (TX2N), TX2_N1.1
TX2_P: IC1.19 (TX2P), TX2_P1.1
USB3DN_3_D_N: D1.3 (IO2), J4.2 (D-)
USB3DN_3_D_P: D1.2 (IO1), J4.3 (D+)
USB3DN_4_D_N: D7.2 (IO1), J5.2 (D-)
USB3DN_4_D_P: D7.3 (IO2), J5.3 (D+)
USB3DN_5_D_N: D4.2 (IO1), J3.A7 (D-), J3.B7 (D-)
USB3DN_5_D_P: D4.3 (IO2), J3.A6 (D+), J3.B6 (D+)
USB3DN_RXD_3_N: D3.2 (IO1), J4.5 (SSRX-)
USB3DN_RXD_3_P: D3.3 (IO2), J4.6 (SSRX+)
USB3DN_RXD_4_N: D9.2 (IO1), J5.5 (SSRX-)
USB3DN_RXD_4_P: D9.3 (IO2), J5.6 (SSRX+)
USB3DN_RXD_5_N: D6.2 (IO1), J3.B10 (RX1-)
USB3DN_RXD_5_P: D6.3 (IO2), J3.B11 (RX1+)
USB3DN_TXD_3_N: D2.2 (IO1), J4.8 (SSTX-)
USB3DN_TXD_3_P: D2.3 (IO2), J4.9 (SSTX+)
USB3DN_TXD_4_N: D8.2 (IO1), J5.8 (SSTX-)
USB3DN_TXD_4_P: D8.3 (IO2), J5.9 (SSTX+)
USB3DN_TXD_5_N: D5.2 (IO1), J3.A3 (TX1-)
USB3DN_TXD_5_P: D5.3 (IO2), J3.A2 (TX1+)
USB3UP_RXDN: IC1.4 (SSRXN)
USB3UP_RXDP: IC1.5 (SSRXP)
USB3UP_TXDN: IC1.7 (SSTXN)
USB3UP_TXDP: IC1.8 (SSTXP)
VBUS: TP2.1, VBUS1.1

Notes on the sheet:
Iset=6800/rs 1A limit r2=6.8k
USB BUS 2
ETHERNET TO USB PHY
MICRO SD & TF INTERFACE
DIAPLAY PORT ENABLED
SINK PD MANAGEMENT IC
POWER MANAGEMENT SECTION
POWER SOURCE FOR ALL INTERNAL CIRCUITRY AND ICs
USB PD CONTROLLER SOURCE MANAGEMENT
POWER DELIVERY MANAGEMENT INTERFACES
OVER CURRENT & SHORT CIRCUIT PROTETION
20V @ 5A
USB C MULTIPLEXER
TVS ESD PROTECTION FOR USB SUPERSPEED LINES
HUB CONTROLLER
HDMI DISPLAY PORT
SD & TF INTERFACE
