R-Mutura/USB_HUB_ADAPTER/USB_HUB_ADAPTER/USB_SOURCE_MANAGEMENT_IC.kicad_sch

## KiCad design USB_HUB_ADAPTER/USB_SOURCE_MANAGEMENT_IC.kicad_sch (2022-11-23)

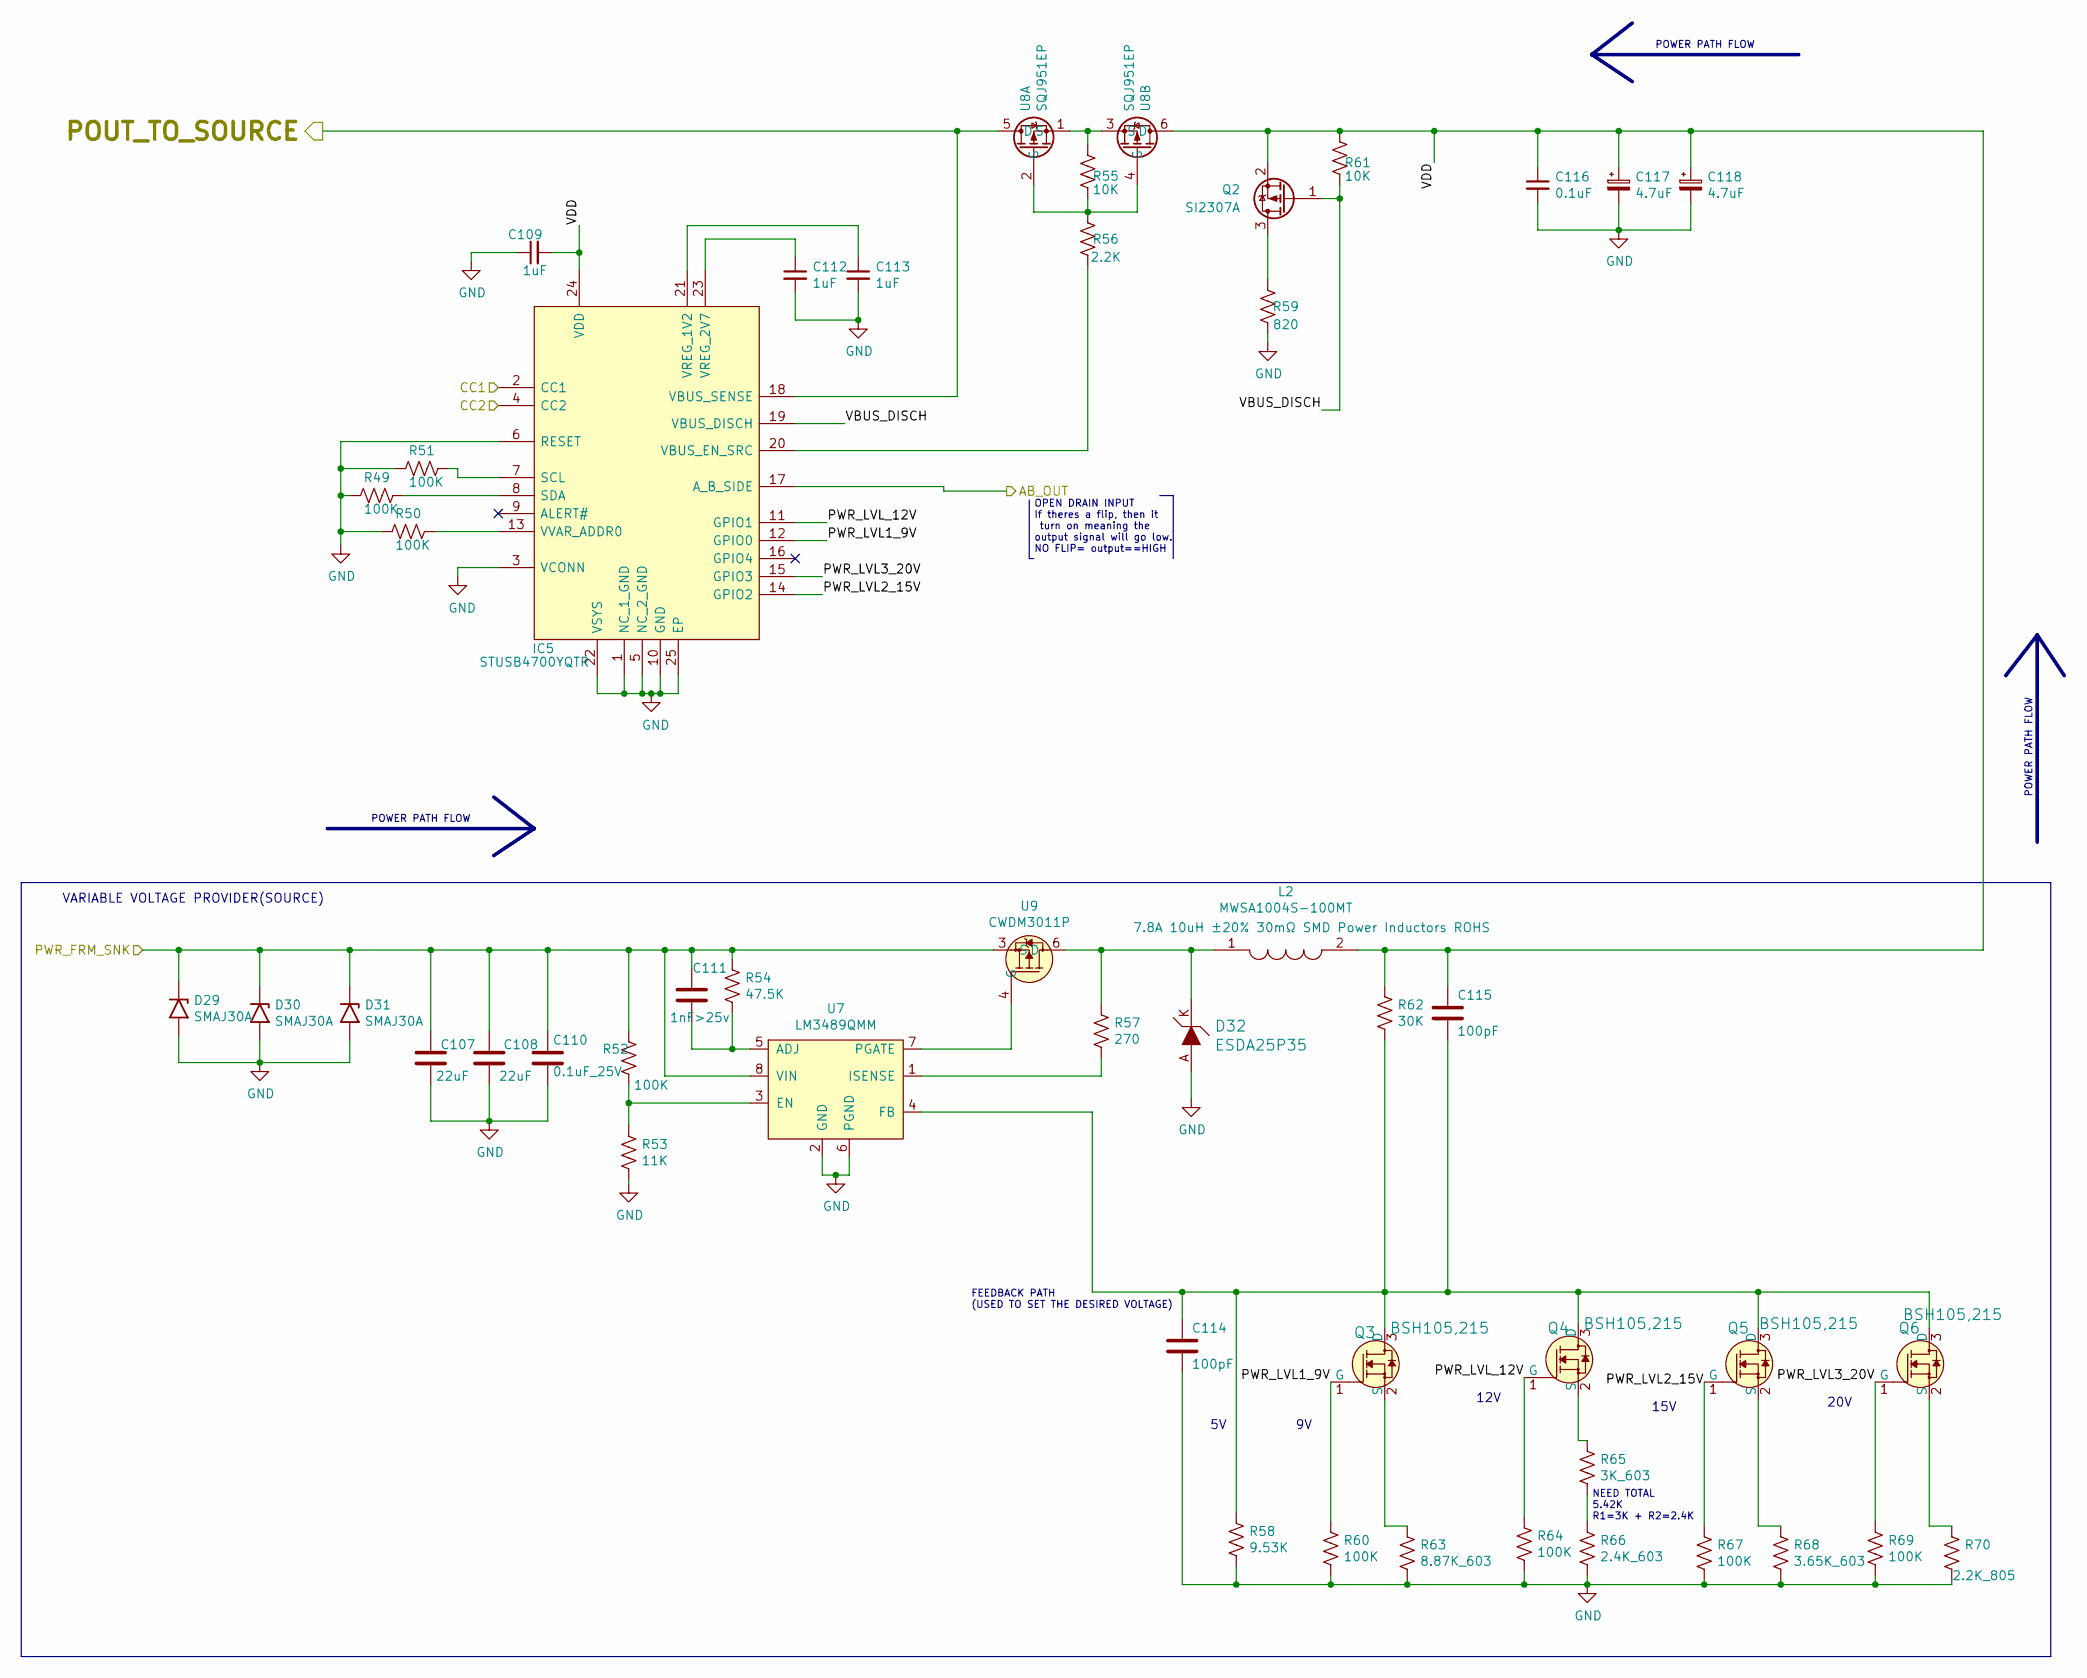
[picture p29: schematic USB_SOURCE_MANAGEMENT_IC.kicad_sch]

Parts:
C107, C108: 22uF; C_0805_2012Metric
C109, C112, C113: 1uF; C_0402_1005Metric
C110: 0.1uF_25V; C_0402_1005Metric
C111: 1nF>25v; C_0402_1005Metric
C114, C115: 100pF; C_0402_1005Metric
C116: 0.1uF; C_0402_1005Metric
C117, C118: 4.7uF; CP_EIA-3528-21_Kemet-B
D29, D30, D31: SMAJ30A; D_SMA
D32: ESDA25P35; SOD-523; MPN ESD5Z3.3T1G; Digi-Key_PN ESD5Z3.3T1GOSCT-ND
IC5: STUSB4700YQTR; QFN-24-1EP_4x4mm_P0.5mm_EP2.7x2.7mm; Mouser Part Number 511-STUSB4700YQTR
L2: MWSA1004S-100MT; MWSA1004S-3R3MT; Mouser Part Number 652-SRP1038A-100M
Q2: SI2307A; SOT-23
Q3, Q4, Q5, Q6: BSH105,215; SOT-23
R49, R50, R51, R60, R64, R67, R69: 100K; R_0402_1005Metric
R52: 100K; R_0603_1608Metric
R53: 11K; R_0603_1608Metric
R54: 47.5K; R_0603_1608Metric
R55, R61: 10K; R_0603_1608Metric
R56: 2.2K; R_0603_1608Metric
R57: 270; R_0603_1608Metric
R58: 9.53K; R_0603_1608Metric
R59: 820; R_0603_1608Metric
R62: 30K; R_0603_1608Metric
R63: 8.87K_603; R_0603_1608Metric
R65: 3K_603; R_0603_1608Metric
R66: 2.4K_603; R_0603_1608Metric
R68: 3.65K_603; R_0603_1608Metric
R70: 2.2K_805; R_0603_1608Metric
U7: LM3489QMM; TSSOP-8_3x3mm_P0.65mm
U8: SQJ951EP; PowerPAK_SO-8_Dual
U9: CWDM3011P; SOIC-8_3.9x4.9mm_P1.27mm

Connections:
AB_OUT: IC5.17 (A_B_SIDE)
CC1: IC5.2 (CC1)
CC2: IC5.4 (CC2)
GND: C107.2, C108.2, C109.1, C110.2, C112.2, C113.2, C114.2, C116.2, C117.2, C118.2, D29.2 (A2), D30.2 (A2), D31.2 (A2), D32.A, IC5.1 (NC_1_GND), IC5.3 (VCONN), IC5.5 (NC_2_GND), IC5.6 (RESET), IC5.10 (GND), IC5.22 (VSYS), IC5.25 (EP), R49.2, R50.2, R51.2, R53.2, R58.2, R59.2, R60.2, R63.2, R64.2, R66.2, R67.2, R68.2, R69.2, R70.2, U7.2 (GND), U7.6 (PGND)
unnamed: C111.2, R54.2, U7.5 (ADJ)
unnamed: C112.1, IC5.23 (VREG_2V7)
unnamed: C113.1, IC5.21 (VREG_1V2)
unnamed: C114.1, C115.2, Q3.3 (D), Q4.3 (D), Q5.3 (D), Q6.3 (D), R58.1, R62.2, U7.4 (FB)
unnamed: D32.K, L2.1, R57.1, U9.6 (D), U9.7 (D), U9.8 (D)
unnamed: IC5.7 (SCL), R51.1
unnamed: IC5.8 (SDA), R49.1
unnamed: IC5.13 (VVAR_ADDR0), R50.1
unnamed: IC5.20 (VBUS_EN_SRC), R56.2
unnamed: Q2.3 (D), R59.1
unnamed: Q3.2 (S), R63.1
unnamed: Q4.2 (S), R65.1
unnamed: Q5.2 (S), R68.1
unnamed: Q6.2 (S), R70.1
unnamed: R52.2, R53.1, U7.3 (EN)
unnamed: R55.1, U8.1 (S), U8.3 (S)
unnamed: R55.2, R56.1, U8.2 (G), U8.4 (G)
unnamed: R57.2, U7.1 (ISENSE)
unnamed: R65.2, R66.1
unnamed: U7.7 (PGATE), U9.4 (G)
POUT_TO_SOURCE: IC5.18 (VBUS_SENSE), U8.5 (D)
PWR_FRM_SNK: C107.1, C108.1, C110.1, C111.1, D29.1 (A1), D30.1 (A1), D31.1 (A1), R52.1, R54.1, U7.8 (VIN), U9.1 (S), U9.2 (S), U9.3 (S)
PWR_LVL1_9V: IC5.12 (GPIO0), Q3.1 (G), R60.1
PWR_LVL2_15V: IC5.14 (GPIO2), Q5.1 (G), R67.1
PWR_LVL3_20V: IC5.15 (GPIO3), Q6.1 (G), R69.1
PWR_LVL_12V: IC5.11 (GPIO1), Q4.1 (G), R64.1
VBUS_DISCH: IC5.19 (VBUS_DISCH), Q2.1 (G), R61.2
VDD: C109.2, C115.1, C116.1, C117.1, C118.1, IC5.24 (VDD), L2.2, Q2.2 (S), R61.1, R62.1, U8.6 (D)

Notes on the sheet:
12V
NEED TOTAL 5.42K R1=3K + R2=2.4K
VARIABLE VOLTAGE PROVIDER(SOURCE)
POWER PATH FLOW
FEEDBACK PATH (USED TO SET THE DESIRED VOLTAGE)
15V
OPEN DRAIN INPUT If theres a flip, then it turn on meaning the output signal will go low. NO FLIP= output==HIGH
20V
