R-Mutura/USB_HUB_ADAPTER/USB_HUB_ADAPTER/audio_codec_TLV320AIC3104IRHBR.kicad_sch

## KiCad design USB_HUB_ADAPTER/audio_codec_TLV320AIC3104IRHBR.kicad_sch (2022-11-24)

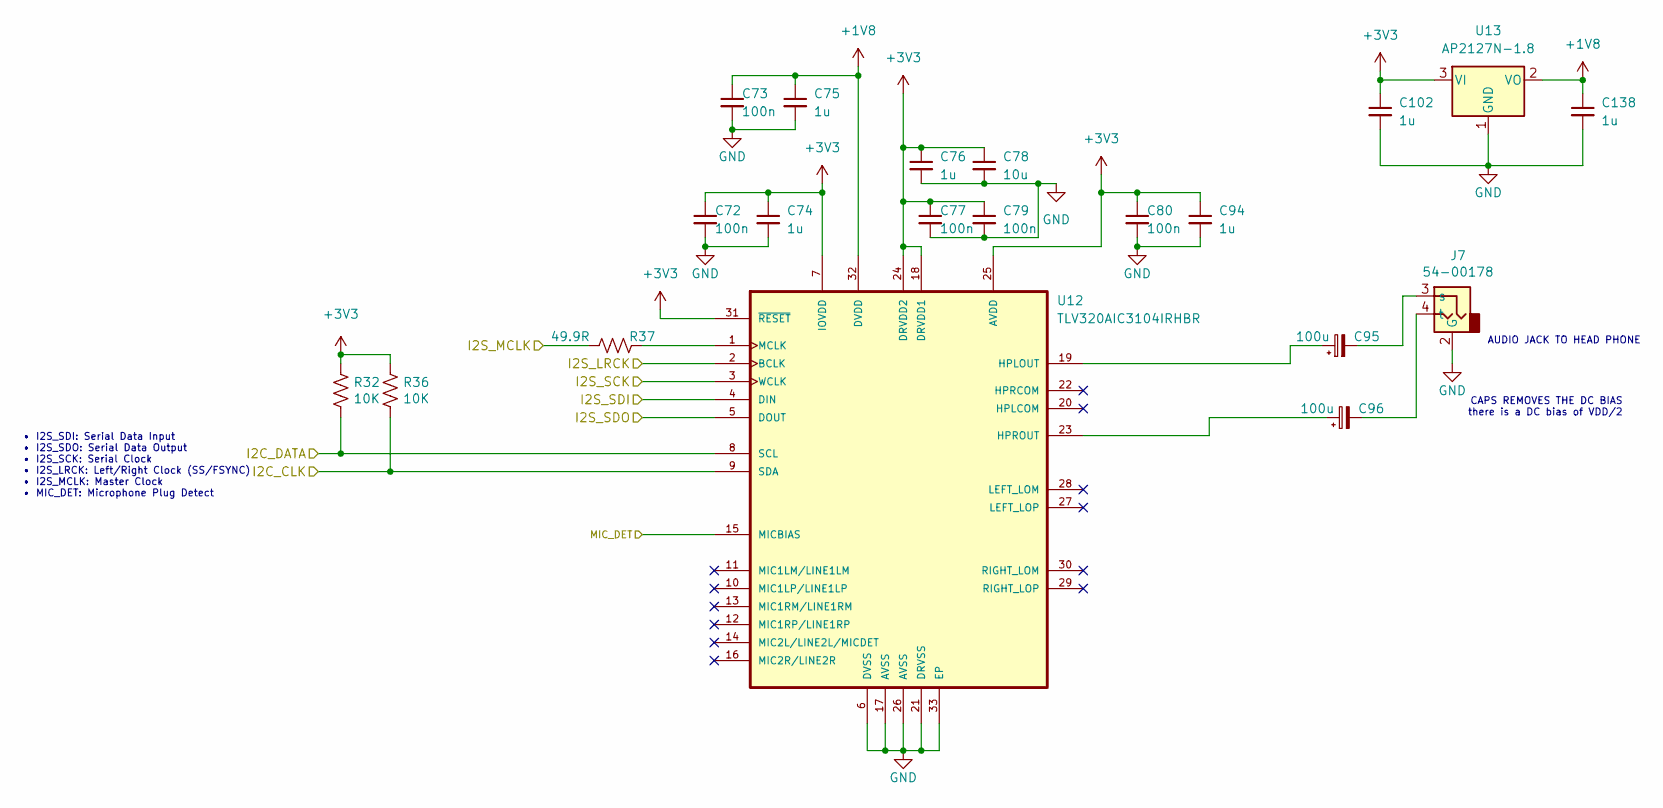
[picture p30: schematic audio_codec_TLV320AIC3104IRHBR.kicad_sch]

Parts:
C72, C73, C77, C79, C80: 100n; C_0402_1005Metric
C74, C75, C76, C94, C102, C138: 1u; C_0402_1005Metric
C78: 10u; C_0402_1005Metric
C95, C96: 100u; CP_EIA-3528-21_Kemet-B
J7: 54-00178; Jack_3.5mm_PJ311_Horizontal
R32, R36: 10K; R_0402_1005Metric
R37: 49.9R; R_0402_1005Metric
U12: TLV320AIC3104IRHBR; VQFN-32-1EP_5x5mm_P0.5mm_EP3.5x3.5mm
U13: AP2127N-1.8; SOT-23

Connections:
+1V8: C73.1, C75.1, C138.1, U12.32 (DVDD), U13.2 (VO)
+3V3: C72.1, C74.1, C76.1, C77.1, C78.1, C79.1, C80.1, C94.1, C102.1, R32.1, R36.1, U12.7 (IOVDD), U12.18 (DRVDD1), U12.24 (DRVDD2), U12.25 (AVDD), U12.31 (~RESET), U13.3 (VI)
GND: C72.2, C73.2, C74.2, C75.2, C76.2, C77.2, C78.2, C79.2, C80.2, C94.2, C102.2, C138.2, J7.2 (G), U12.6 (DVSS), U12.17 (AVSS), U12.21 (DRVSS), U12.26 (AVSS), U12.33 (EP), U13.1 (GND)
I2C_CLK: R36.2, U12.9 (SDA)
I2C_DATA: R32.2, U12.8 (SCL)
I2S_LRCK: U12.2 (BCLK)
I2S_MCLK: R37.1
I2S_SCK: U12.3 (WCLK)
I2S_SDI: U12.4 (DIN)
I2S_SDO: U12.5 (DOUT)
MIC_DET: U12.15 (MICBIAS)
unnamed: C95.1, U12.19 (HPLOUT)
unnamed: C95.2, J7.3 (s)
unnamed: C96.1, U12.23 (HPROUT)
unnamed: C96.2, J7.4 (t)
unnamed: R37.2, U12.1 (MCLK)

Notes on the sheet:
CAPS REMOVES THE DC BIAS there is a DC bias of VDD/2
• I2S_SDI: Serial Data Input • I2S_SDO: Serial Data Output • I2S_SCK: Serial Clock • I2S_LRCK: Left/Right Clock (SS/FSYNC) • I2S_MCLK: Master Clock • MIC_DET: Microphone Plug Detect
AUDIO JACK TO HEAD PHONE
