R-Mutura/USB_HUB_ADAPTER/USB_HUB_ADAPTER/buck_conveter_1v1_1A.kicad_sch

## KiCad design USB_HUB_ADAPTER/buck_conveter_1v1_1A.kicad_sch (2022-11-23)

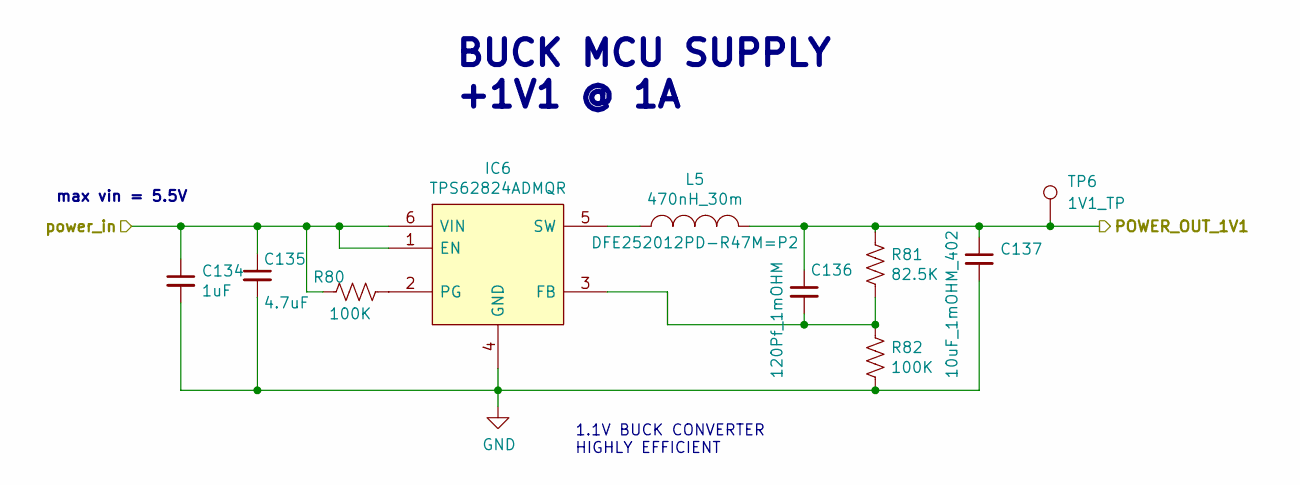
[picture p31: schematic buck_conveter_1v1_1A.kicad_sch]

Parts:
C134: 1uF; C_0402_1005Metric
C135: 4.7uF; C_0402_1005Metric
C136: 120Pf_1mOHM; C_0402_1005Metric
C137: 10uF_1mOHM_402; C_0402_1005Metric
IC6: TPS62824ADMQR; Manufacturer_Part_Number TPS62824ADMQR
L5: 470nH_30m; DFE252012PD-xxx
R80, R82: 100K; R_0603_1608Metric
R81: 82.5K; R_0603_1608Metric
TP6: 1V1_TP; TestPoint_Pad_D0.9mm

Connections:
GND: C134.2, C135.2, C137.2, IC6.4 (GND), R82.2
unnamed: C136.2, IC6.3 (FB), R81.2, R82.1
unnamed: IC6.2 (PG), R80.2
unnamed: IC6.5 (SW), L5.1
POWER_OUT_1V1: C136.1, C137.1, L5.2, R81.1, TP6.1
power_in: C134.1, C135.1, IC6.1 (EN), IC6.6 (VIN), R80.1

Notes on the sheet:
BUCK MCU SUPPLY +1V1 @ 1A
max vin = 5.5V
1.1V BUCK CONVERTER HIGHLY EFFICIENT
