R-Mutura/USB_HUB_ADAPTER/(commit log)

2022-11-23 version 1 commit completed
    [AUDIO_DAC_CONVERTER.kicad_sch, BUCK_CONVERTER_3V3_2A.kicad_sch, BUCK_CONVERTER_5V_5A_LM25085.kicad_sch, DESIGN FLOW SHEET.kicad_sch, DP TO HDMI INTERFACE.kicad_sch, ETHERNET_TO_USB_PHY_LAN7805.kicad_sch, LAN_TO_USN2.kicad_sch, PD_USB_C_SINK_CONTROLLER.kicad_sch]
2022-11-24 v2 layout update
    [LAN_TO_USN2.kicad_sch, USB_HUB_ADAPTER.csv, USB_HUB_ADAPTER.kicad_sch, USB_HUB_ADAPTER_V2.xlsx, V2_PROPOSED_bom_USB_HUB_ADAPTER..xlsx, audio_codec_TLV320AIC3104IRHBR.kicad_sch]
2022-11-24 completed routing and layout
    [USB_HUB_ADAPTER-B_Cu.gbr, USB_HUB_ADAPTER-B_Mask.gbr, USB_HUB_ADAPTER-B_Paste.gbr, USB_HUB_ADAPTER-B_Silkscreen.gbr, USB_HUB_ADAPTER-Edge_Cuts.gbr, USB_HUB_ADAPTER-F_Cu.gbr, USB_HUB_ADAPTER-F_Mask.gbr, USB_HUB_ADAPTER-F_Paste.gbr]
2022-11-25 all files completed
    [USB_HUB_ADAPTER.xlsx, USB_HUB_ADAPTER_V2.xlsx, V2_PROPOSED_bom_USB_HUB_ADAPTER..xlsx]
